AlvinStf/electronic-drum-kit/firmware/library_patch/README.txt

hellodrum.cpp adalah SALINAN PERSIS lampiran pengguna, bukan patch algoritma baru.

Gunakan untuk mengganti src/hellodrum.cpp dalam instalasi HelloDrum yang aktif
hanya bila instalasi tersebut belum memakai versi ini. Cadangkan berkas lama.
Pertahankan hellodrum.h dan berkas pendukung lain yang cocok dari instalasi Anda.

JANGAN masukkan .cpp ini ke folder sketch dan JANGAN #include .cpp langsung:
itu berpotensi membuat definisi ganda dengan library HelloDrum yang terpasang.

Filter FSRSensing alpha=0.01, delay(1), skala/polaritas ADC, status pedal, dan
seluruh logika lain tidak diubah. SHA-256:
b712c8808129ecfc52d5b6a69663e7c554ee2b78dedabaf64d7eca7d29205d3a
