AlvinStf/electronic-drum-kit/PCB/drumModule/BOM.xlsx

No. | Quantity | Comment | Designator | Footprint | Value | Manufacturer Part | Manufacturer | Supplier Part | Supplier
1 | 1 | 10uF | C1 | C0805 | 10uF | CL21A106KAYNNNE | SAMSUNG(三星) | C15850 | LCSC
2 | 1 | 100nF | C2 | C0805 | 100nF | CL21B104KCFNNNE | SAMSUNG(三星) | C28233 | LCSC
3 | 1 | 4.7uF | C3 | C0805 | 4.7uF | CL21A475KAQNNNE | SAMSUNG(三星) | C1779 | LCSC
4 | 2 | 1uF | C4,C6 | C0805 | 1uF | CL21B105KBFNNNE | SAMSUNG(三星) | C28323 | LCSC
5 | 2 | 100uF | C5,C7 | C1206 | 100uF | CL31A107MQHNNNE | SAMSUNG(三星) | C15008 | LCSC
6 | 9 | 10nF | C8,C9,C10,C11,C12,C13,C14,C15,C16 | C0805 | 10nF | CL21B103KBANNNC | SAMSUNG(三星) | C1710 | LCSC
7 | 1 | PJ-603 | CN1 | AUDIO-TH_PJ-603 |  | PJ-603 | Legion(六钧) | C41409498 | LCSC
8 | 1 | HDR-F_2.54_1x8P | H1 | HDR-TH_8P-P2.54-V-F-1
9 | 9 | PJ-612 | J1,J2,J3,J4,J5,J6,J8,J9,J10 | AUDIO-TH_PJ-612 |  | PJ-612 | HOOYA(皓宇电子) | C309284 | LCSC
10 | 14 | 100kΩ | R1,R2,R3,R4,R5,R7,R9,R12,R13,R17,R19,R23,R25,R27 | R0805 | 100kΩ | 0805W8F1003T5E | UNI-ROYAL(厚声) | C149504 | LCSC
11 | 10 | 1MΩ | R6,R8,R10,R14,R15,R20,R21,R24,R26,R28 | R0805 | 1MΩ | 0805W8F1004T5E | UNI-ROYAL(厚声) | C17514 | LCSC
12 | 3 | 10kΩ | R11,R22,R32 | R0805 | 10kΩ | 0805W8F1002T5E | UNI-ROYAL(厚声) | C17414 | LCSC
13 | 2 | 4.7kΩ | R16,R33 | R0805 | 4.7kΩ | KTR10EZPF4701 | ROHM(罗姆) | C2087066 | LCSC
14 | 1 | 10kΩ | R30 | RES-ADJ-TH_RK09L1140A65 | 10kΩ | RK09L1140A66 | ALPSALPINE(阿尔卑斯阿尔派) | C470447 | LCSC
15 | 3 | Key_SMD_6x6x10.5 | SW1,SW2,SW3 | KEY-SMD_4P-L6.0-W6.0-P3.90-LS9.0
16 | 1 | TDA1308T/N1 | U1 | SOIC-8_L4.9-W3.9-P1.27-LS6.0-BL |  | TDA1308T/N1 | NXP(恩智浦) | C29767341 | LCSC
17 | 1 | PCM5102 | U2 | PCM5102 | PCM5102
18 | 1 | ESP32-S3-N16R8 | U4 | COMM-TH_ESP32-S3-DEVKITC-N16R8 |  | ESP32-S3-N16R8 |  | C9900309792 | LCSC
19 | 1 | PJ-307 | U5 | AUDIO-TH_PJ-307N5 |  | PJ-307 |  | C9900013026 | LCSC
20 | 10 | BZT52C3V3 | ZD1,ZD2,ZD3,ZD4,ZD5,ZD6,ZD7,ZD8,ZD9,ZD10 | SOD-123_L2.8-W1.8-LS3.7-RD |  | BZT52C3V3 | CJ(江苏长电/长晶) | C2112 | LCSC
