AlvinStf/electronic-drum-kit/PCB/sensors/BOM.xlsx

No. | Quantity | Comment | Designator | Footprint | Value | Manufacturer Part | Manufacturer | Supplier Part | Supplier
1 | 1 | 100pF | C1 | C0805 | 100pF | CL21C101JBANNNC | SAMSUNG(三星) | C1790 | LCSC
2 | 1 | S3B-XH-A(LF)(SN) | CN1 | CONN-TH_S3B-XH-A-LF-SN |  | S3B-XH-A(LF)(SN) | JST | C157928 | LCSC
3 | 1 | 1N4148W | D1 | SOD-123F_L2.7-W1.6-LS3.8-RD |  | 1N4148W | ST(先科) | C81598 | LCSC
4 | 1 | HDR-F_2.54_1x3P | H1 | HDR-TH_3P-P2.54-V-F
5 | 3 | 2.54-1*2P母 | H2,H3,H4 | HDR-TH_2P-P2.54-V-F |  | 2.54-1*2P母 | BOOMELE(博穆精密) | C49661 | LCSC
6 | 2 | 10kΩ | R1,R7 | R0805 | 10kΩ | 0805W8F1002T5E | UNI-ROYAL(厚声) | C17414 | LCSC
7 | 2 | 150kΩ | R2,R5 | R0805 | 150kΩ | 0805W8F1503T5E | UNI-ROYAL(厚声) | C17470 | LCSC
8 | 1 | 220Ω | R3 | R0805 | 220Ω | 0805W8F2200T5E | UNI-ROYAL(厚声) | C17557 | LCSC
9 | 1 | 1kΩ | R4 | R0805 | 1kΩ | 0805W8F1001T5E | UNI-ROYAL(厚声) | C17513 | LCSC
10 | 1 | 47kΩ | R6 | R0805 | 47kΩ | 0805W8F4702T5E | UNI-ROYAL(厚声) | C17713 | LCSC
11 | 6 | TS-1101-C-W | SW1,SW2,SW3,SW4,SW5,SW6 | SW-SMD_L6.0-W3.3-LS8.0_TS-1101-C-W |  | TS-1101-C-W | XKB Connection(中国星坤) | C318938 | LCSC
12 | 4 | TS5208A 160gf 025 | U1,U2,U3,U4 | KEY-SMD_4P-L4.8-W4.8-P3.70-LS6.4-TL |  | TS5208A 160gf 025 | SHOU HAN(首韩) | C5363479 | LCSC
