AlvinStf/electronic-drum-kit/hardware/STLs/Hi-hat Main Body.STL

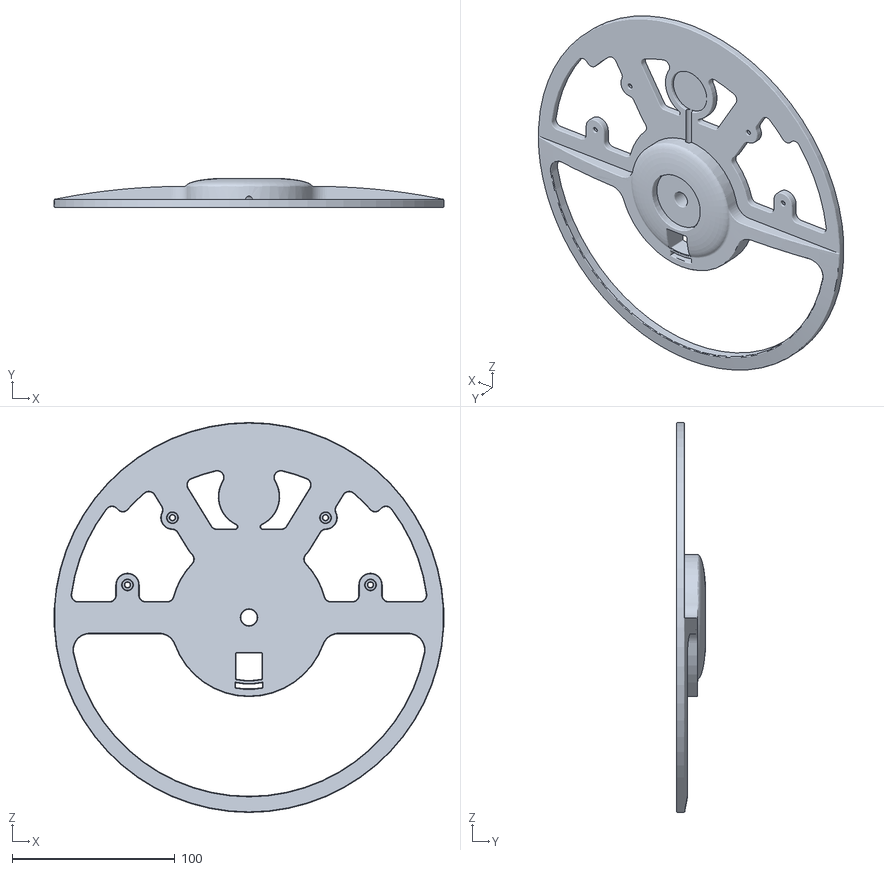
[picture p1: CAD file, 2026-10-14]
hardware/STLs/Hi-hat Main Body.STL
240.0 x 17.9 x 240.0
