AlvinStf/electronic-drum-kit/hardware/STLs/Cymbal Main Body.STL

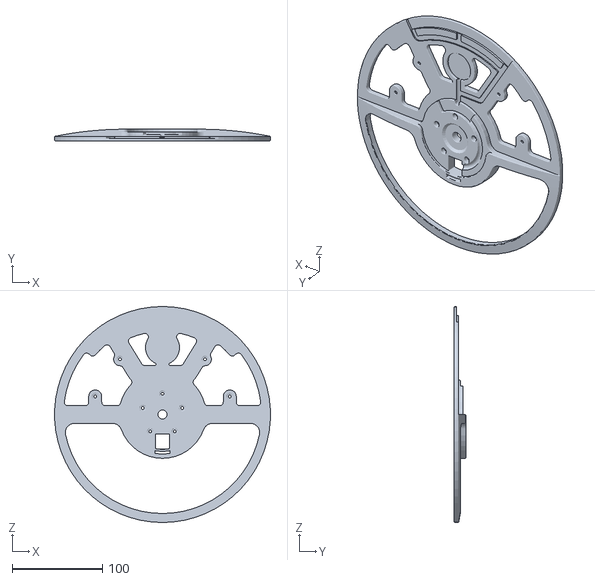
[picture p2: CAD file, 2026-10-14]
hardware/STLs/Cymbal Main Body.STL
240.0 x 13.0 x 240.0
