AlvinStf/electronic-drum-kit/hardware/STLs/Tee Joint - Toolless (B).STL

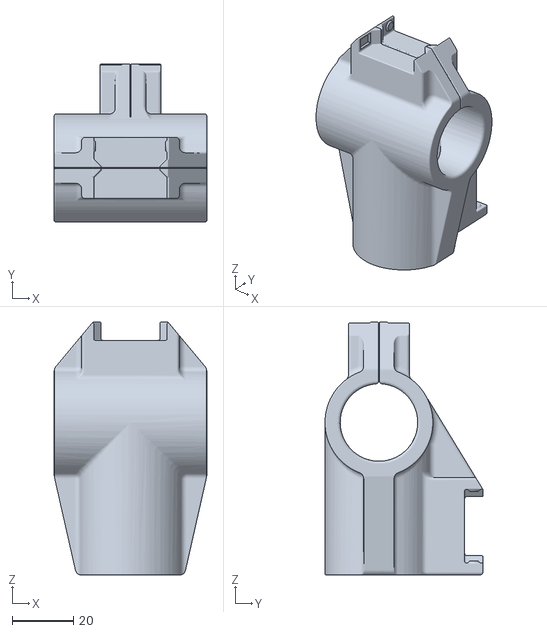
[picture p3: CAD file, 2026-10-14]
hardware/STLs/Tee Joint - Toolless (B).STL
50.0 x 51.8 x 82.9
