AlvinStf/electronic-drum-kit/hardware/STLs/HHC Foot Rest.STL

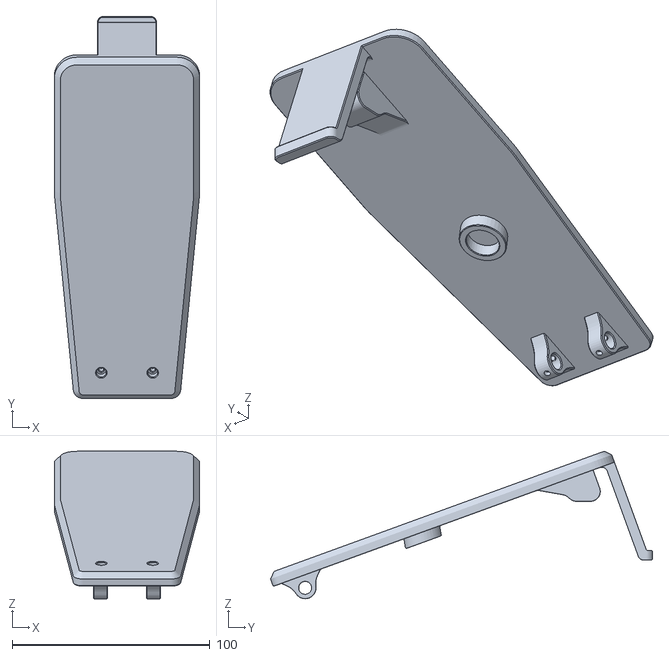
[picture p4: CAD file, 2026-10-14]
hardware/STLs/HHC Foot Rest.STL
73.5 x 193.2 x 74.6
