AlvinStf/electronic-drum-kit/hardware/STLs/Rubber Feet Pad.STL

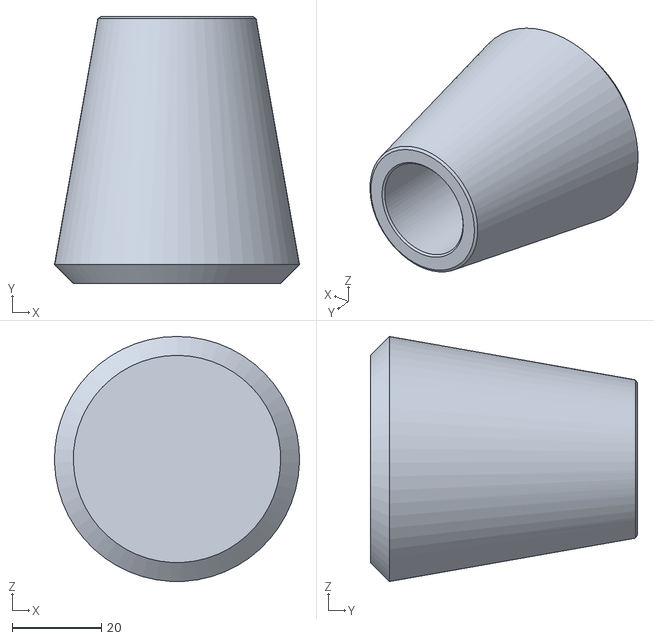
[picture p5: CAD file, 2026-10-14]
hardware/STLs/Rubber Feet Pad.STL
55.0 x 60.0 x 55.1
