AlvinStf/electronic-drum-kit/hardware/STLs/Snare Shell.STL

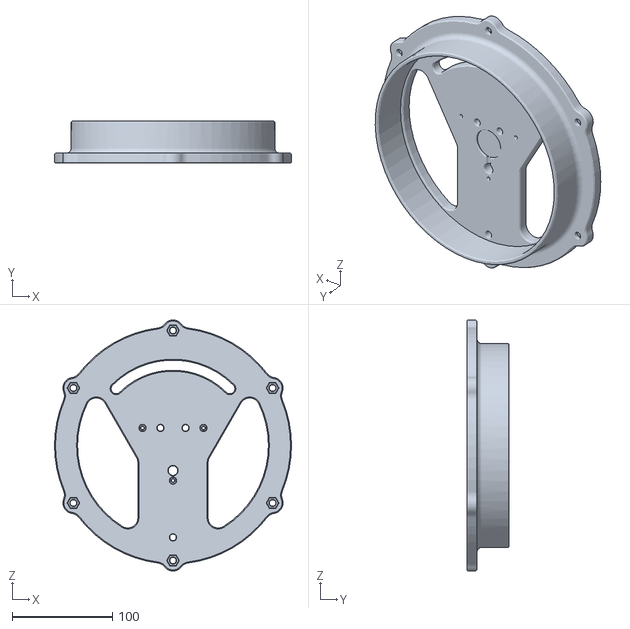
[picture p6: CAD file, 2026-10-14]
hardware/STLs/Snare Shell.STL
236.0 x 42.0 x 249.9
