AlvinStf/electronic-drum-kit/hardware/STLs/Tee Joint & Cymbal Mount.STL

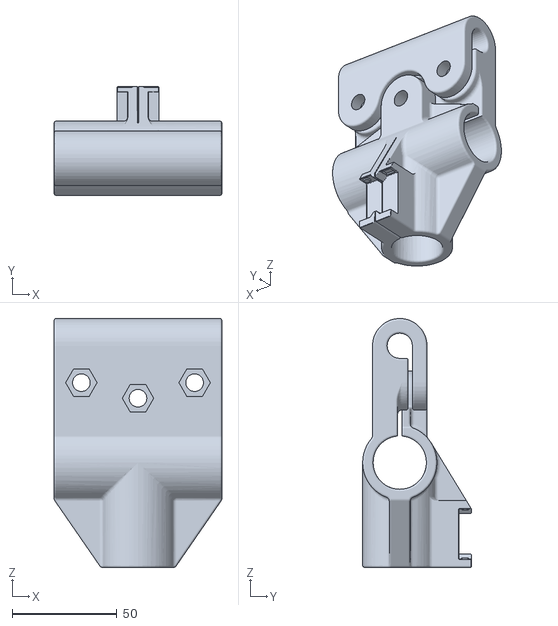
[picture p7: CAD file, 2026-10-14]
hardware/STLs/Tee Joint & Cymbal Mount.STL
80.0 x 51.8 x 118.7
