AlvinStf/electronic-drum-kit/hardware/STLs/Tom Mount.STL

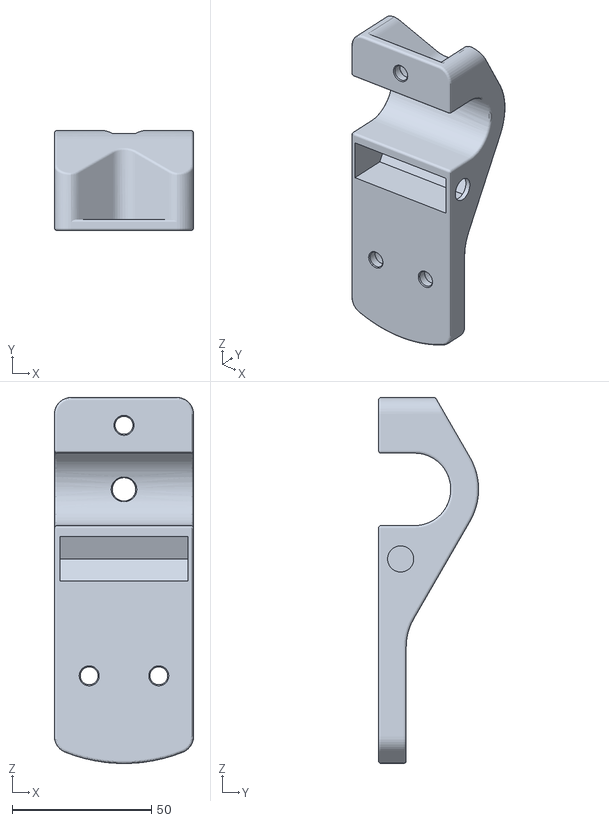
[picture p8: CAD file, 2026-10-14]
hardware/STLs/Tom Mount.STL
50.0 x 36.0 x 131.5
