AlvinStf/electronic-drum-kit/hardware/STLs/Cymbal Edge.STL

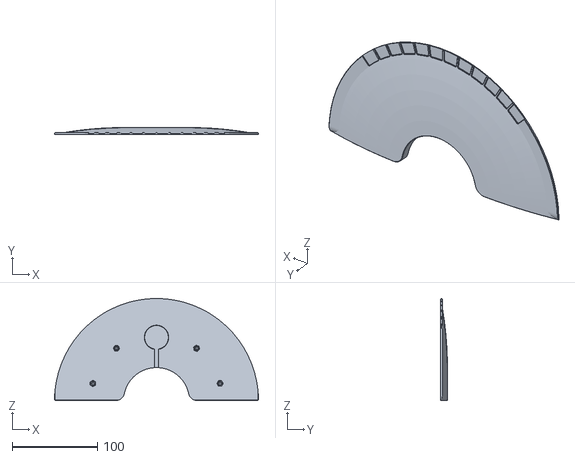
[picture p9: CAD file, 2026-10-14]
hardware/STLs/Cymbal Edge.STL
240.0 x 8.00 x 120.0
