AlvinStf/electronic-drum-kit/hardware/STLs/KTP Pin 1.STL

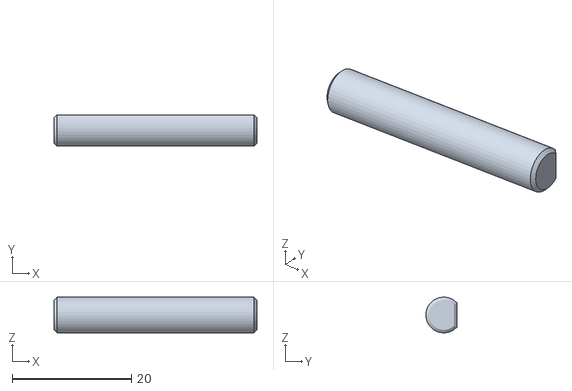
[picture p10: CAD file, 2026-10-14]
hardware/STLs/KTP Pin 1.STL
34.0 x 5.24 x 6.00
