AlvinStf/electronic-drum-kit/hardware/STLs/Cymbal Socket.STL

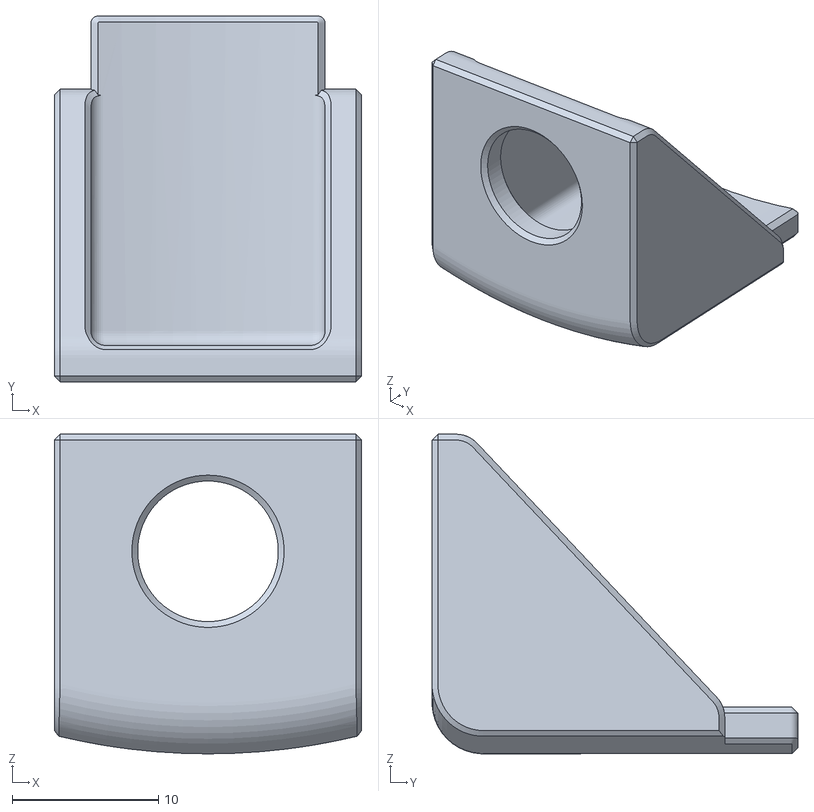
[picture p11: CAD file, 2026-10-14]
hardware/STLs/Cymbal Socket.STL
21.0 x 25.0 x 21.8
