AlvinStf/electronic-drum-kit/hardware/STLs/Sensor Plate.STL

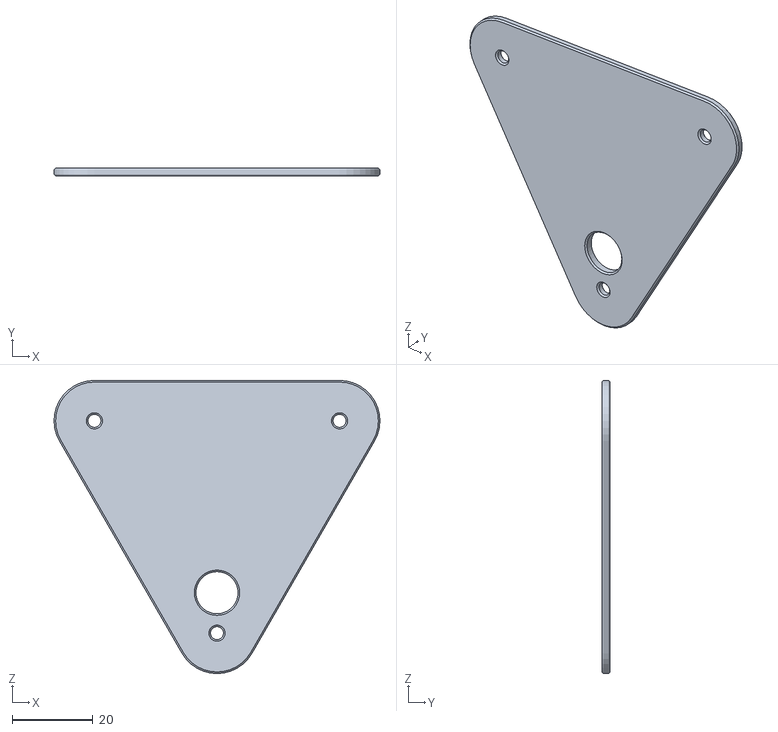
[picture p12: CAD file, 2026-10-14]
hardware/STLs/Sensor Plate.STL
80.6 x 2.00 x 72.5
