AlvinStf/electronic-drum-kit/hardware/STLs/Single Zone Pad.STL

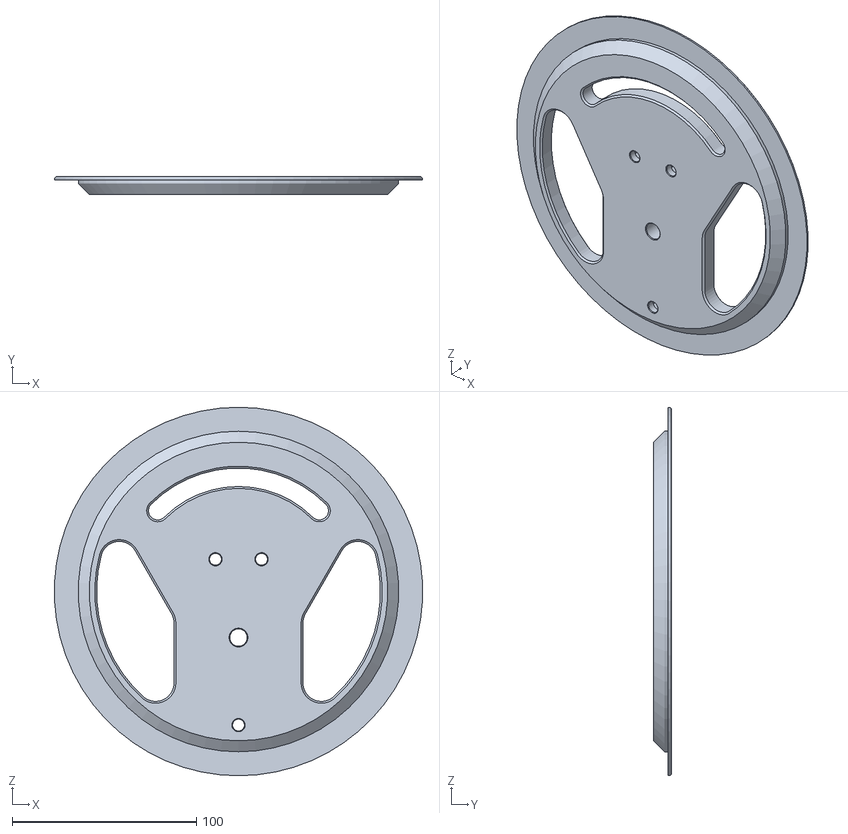
[picture p13: CAD file, 2026-10-14]
hardware/STLs/Single Zone Pad.STL
199.7 x 10.0 x 200.0
