AlvinStf/electronic-drum-kit/hardware/STLs/HHC Base.STL

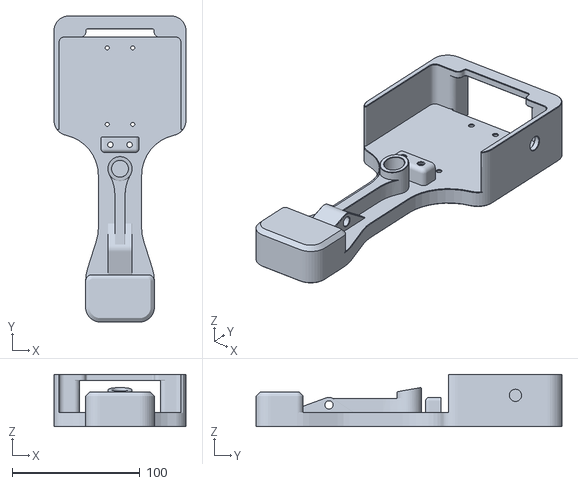
[picture p14: CAD file, 2026-10-14]
hardware/STLs/HHC Base.STL
103.5 x 240.0 x 41.0
