AlvinStf/electronic-drum-kit/hardware/STLs/HHC Pin.STL

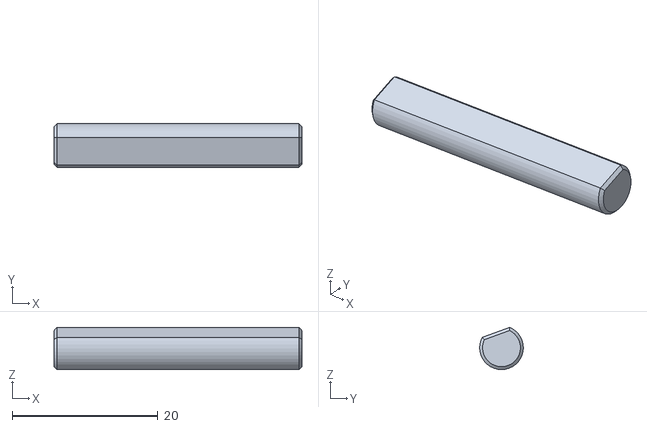
[picture p15: CAD file, 2026-10-14]
hardware/STLs/HHC Pin.STL
34.0 x 6.00 x 5.79
