AlvinStf/electronic-drum-kit/hardware/STLs/Dop.STL

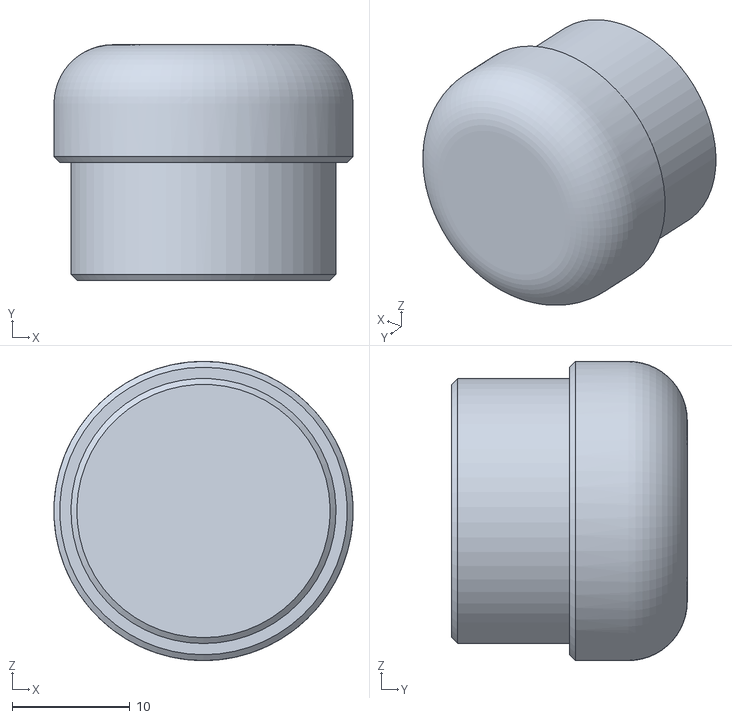
[picture p16: CAD file, 2026-10-14]
hardware/STLs/Dop.STL
25.4 x 20.0 x 25.4
