AlvinStf/electronic-drum-kit/hardware/STLs/Cymbal Mount.STL

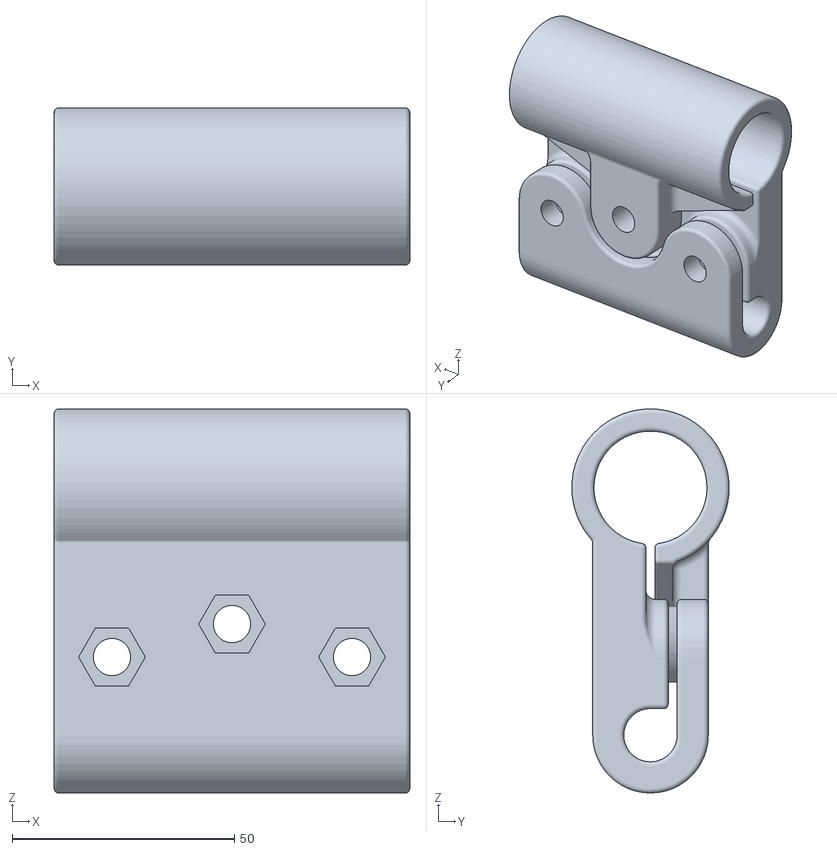
[picture p17: CAD file, 2026-10-14]
hardware/STLs/Cymbal Mount.STL
80.0 x 35.4 x 86.4
