AlvinStf/electronic-drum-kit/hardware/STLs/Rim.STL

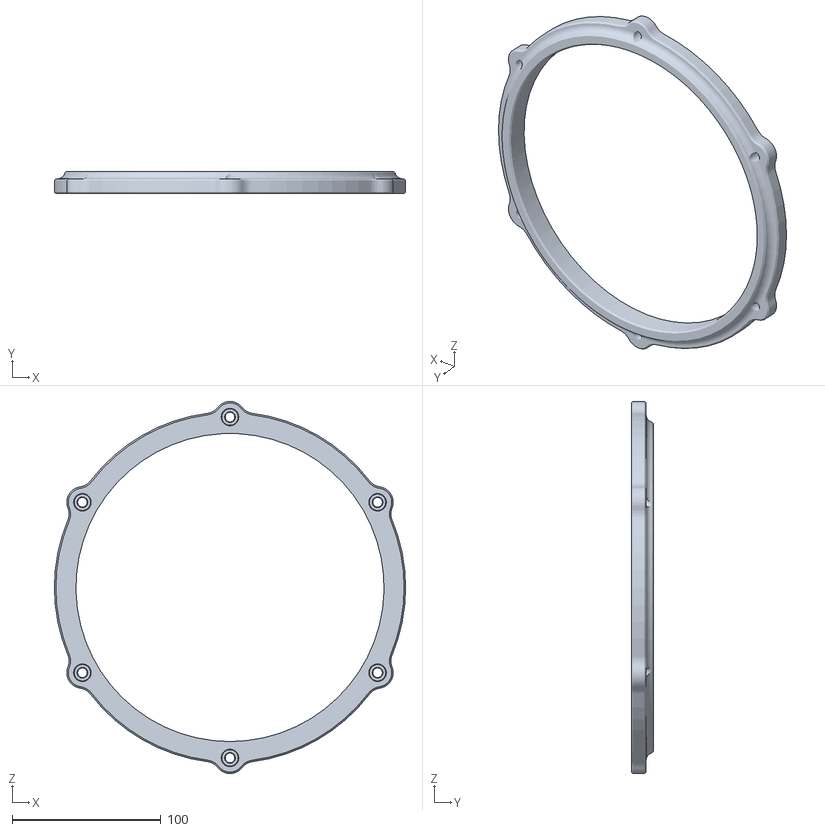
[picture p18: CAD file, 2026-10-14]
hardware/STLs/Rim.STL
236.0 x 15.0 x 249.9
