AlvinStf/electronic-drum-kit/hardware/STLs/Snare Mount.STL

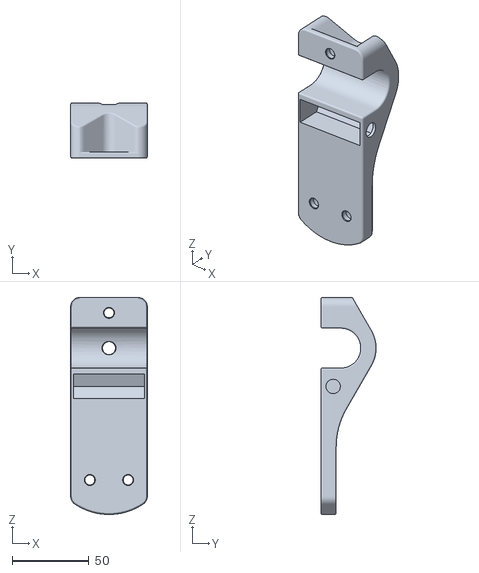
[picture p19: CAD file, 2026-10-14]
hardware/STLs/Snare Mount.STL
50.0 x 36.0 x 141.5
