AlvinStf/electronic-drum-kit/hardware/STLs/KTP Pin 2.STL

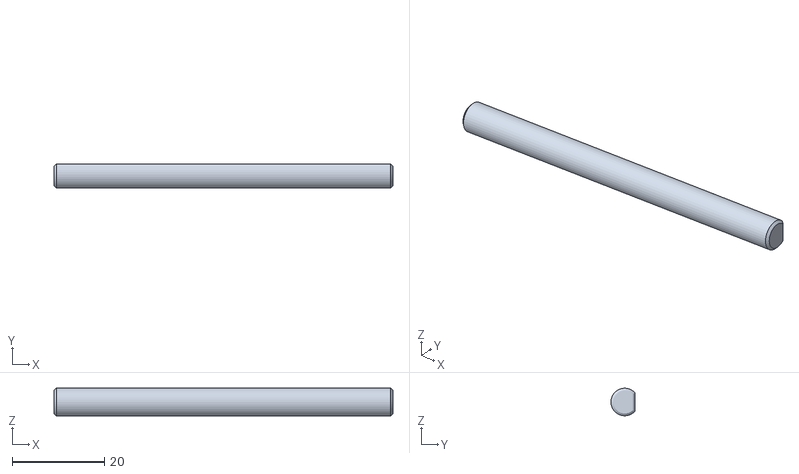
[picture p20: CAD file, 2026-10-14]
hardware/STLs/KTP Pin 2.STL
73.5 x 5.24 x 6.00
