AlvinStf/electronic-drum-kit/hardware/STLs/Cymbal Bell.STL

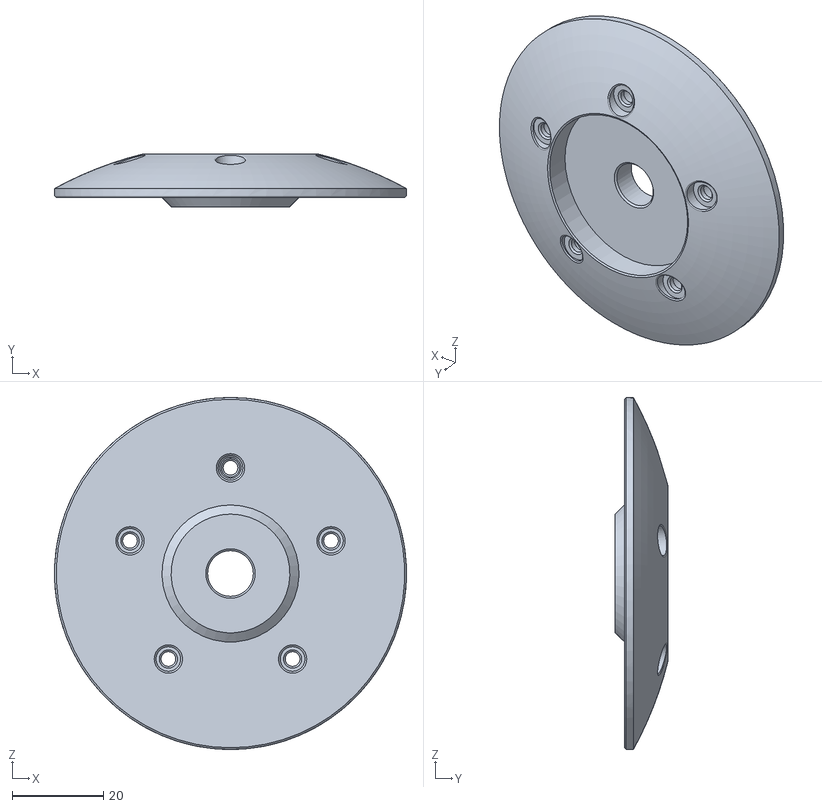
[picture p21: CAD file, 2026-10-14]
hardware/STLs/Cymbal Bell.STL
77.0 x 11.5 x 77.1
