AlvinStf/electronic-drum-kit/hardware/STLs/Drum Module Mount.STL

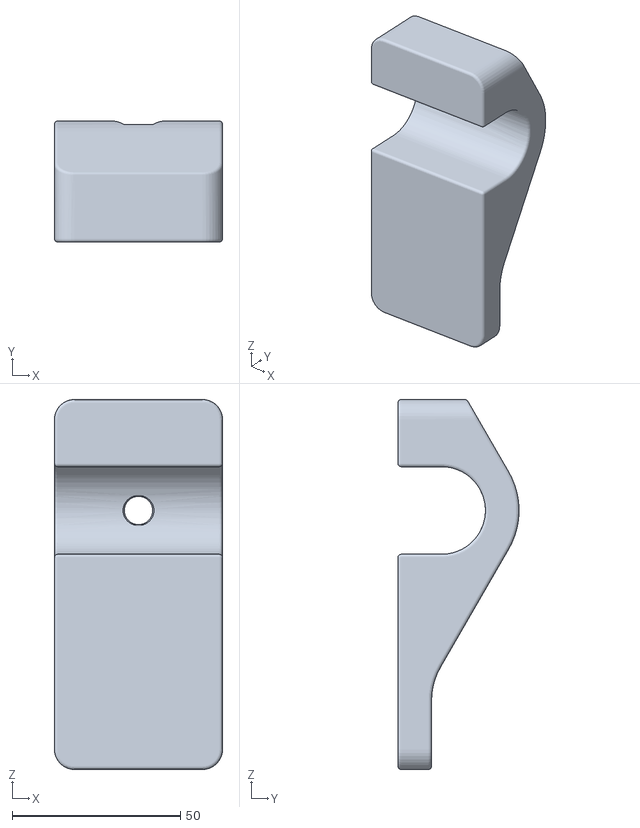
[picture p22: CAD file, 2026-10-14]
hardware/STLs/Drum Module Mount.STL
50.0 x 36.0 x 110.0
