AlvinStf/electronic-drum-kit/hardware/STLs/KTP Pin 3.STL

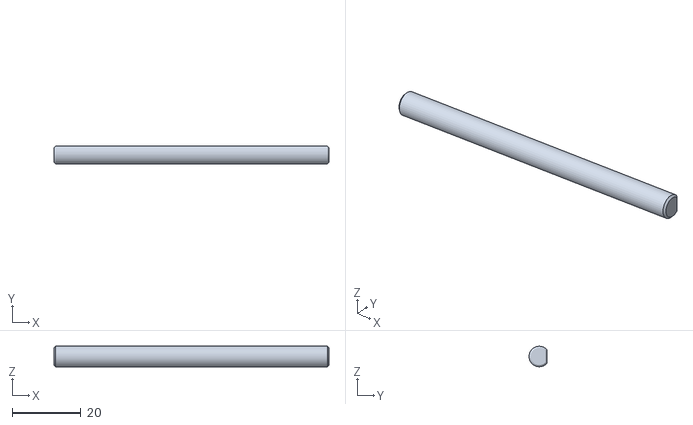
[picture p23: CAD file, 2026-10-14]
hardware/STLs/KTP Pin 3.STL
80.0 x 5.24 x 6.00
