AlvinStf/electronic-drum-kit/hardware/STLs/Cymbal Stand Sleeve.STL

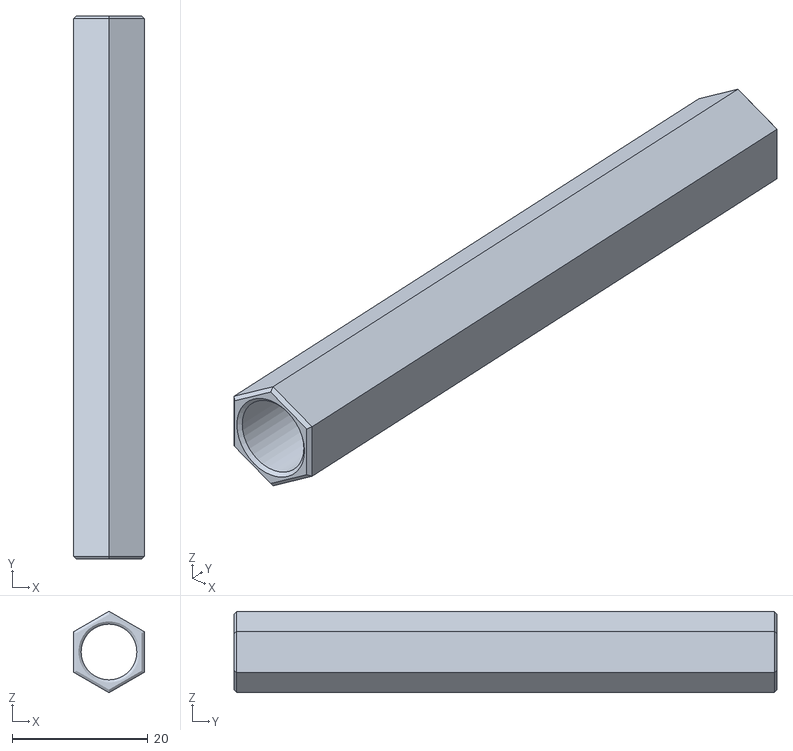
[picture p24: CAD file, 2026-10-14]
hardware/STLs/Cymbal Stand Sleeve.STL
10.4 x 80.0 x 12.0
