AlvinStf/electronic-drum-kit/hardware/STLs/KTP Foot Rest.STL

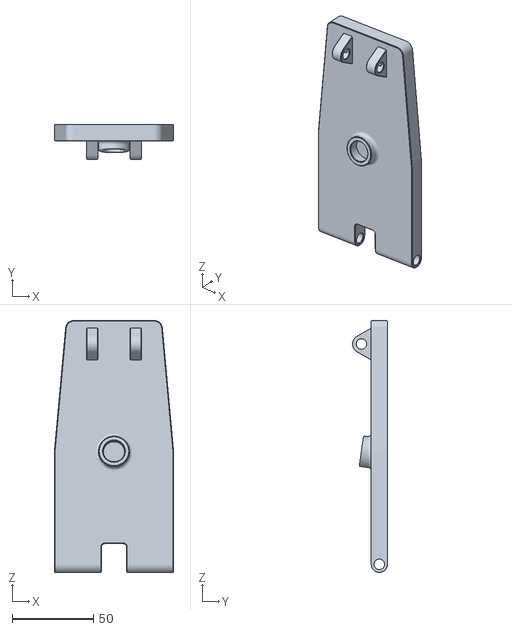
[picture p25: CAD file, 2026-10-14]
hardware/STLs/KTP Foot Rest.STL
73.5 x 21.5 x 155.0
