AlvinStf/electronic-drum-kit/hardware/STLs/HHC Trigger.STL

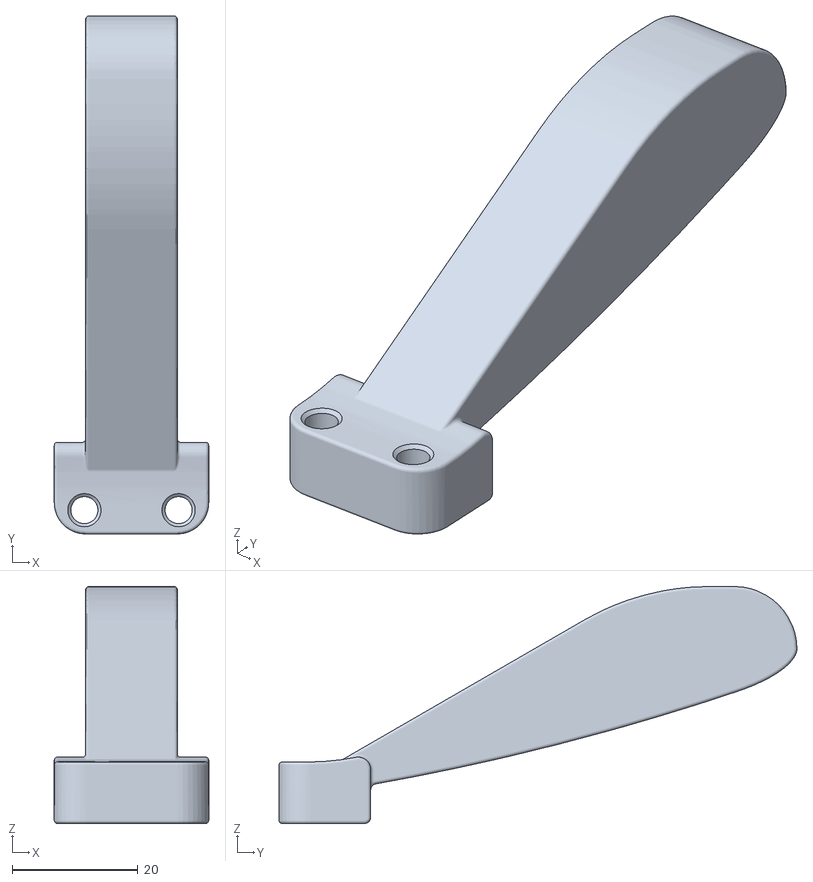
[picture p26: CAD file, 2026-10-14]
hardware/STLs/HHC Trigger.STL
24.6 x 82.5 x 37.7
