AlvinStf/electronic-drum-kit/hardware/STLs/Cymbal Sleeve.STL

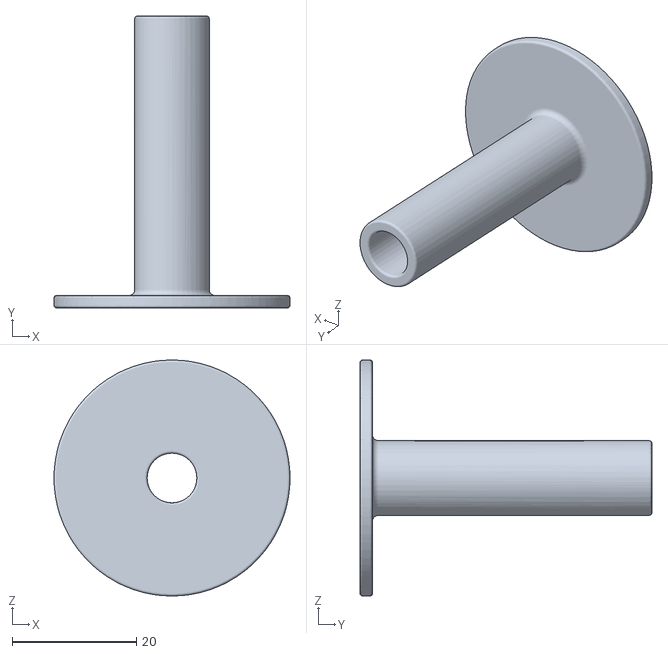
[picture p27: CAD file, 2026-10-14]
hardware/STLs/Cymbal Sleeve.STL
38.0 x 47.0 x 38.0
