AlvinStf/electronic-drum-kit/hardware/STLs/Clasp.STL

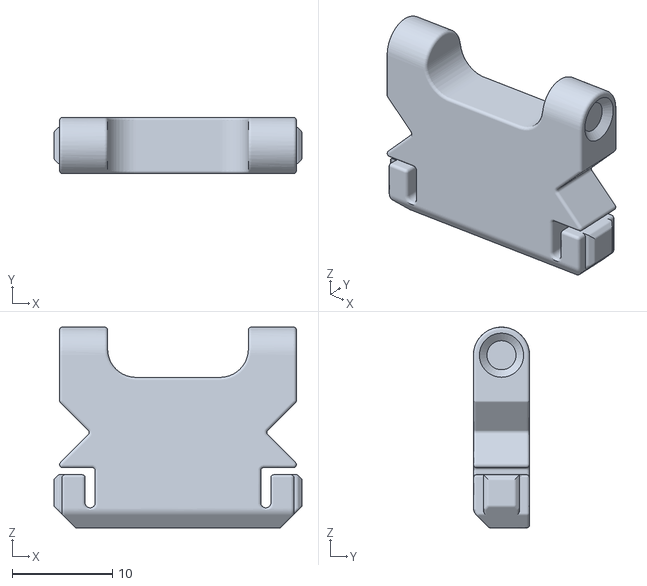
[picture p28: CAD file, 2026-10-14]
hardware/STLs/Clasp.STL
24.7 x 5.60 x 20.0
