AlvinStf/electronic-drum-kit/hardware/STLs/KTP Linkage 1.STL

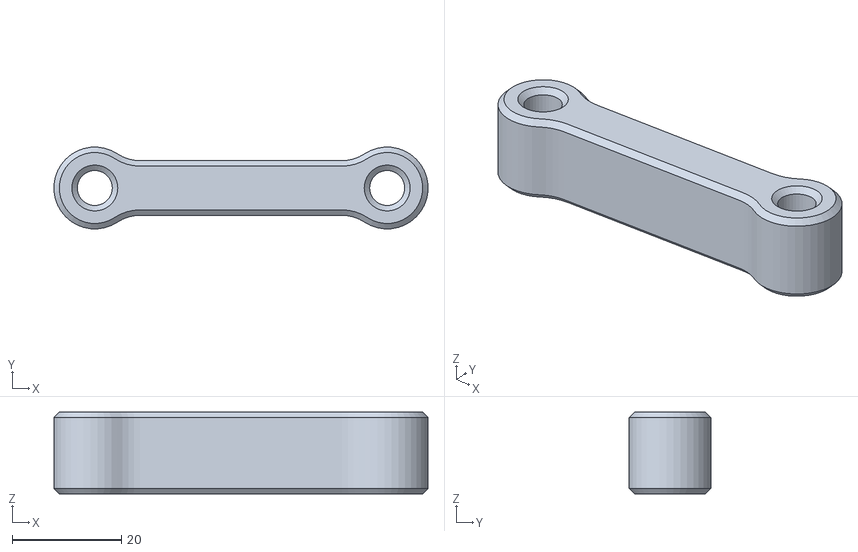
[picture p29: CAD file, 2026-10-14]
hardware/STLs/KTP Linkage 1.STL
68.4 x 15.0 x 15.0
