AlvinStf/electronic-drum-kit/hardware/STLs/KTP Hammer.STL

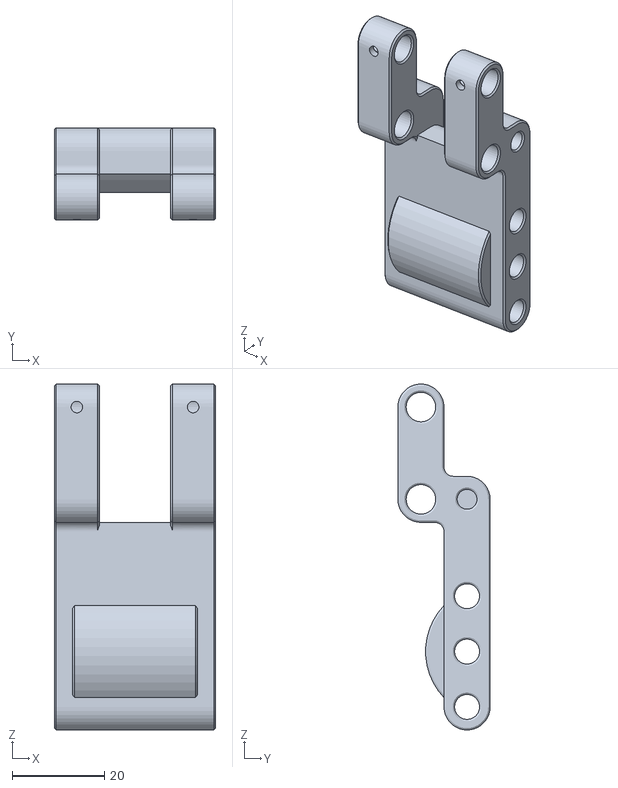
[picture p30: CAD file, 2026-10-14]
hardware/STLs/KTP Hammer.STL
35.0 x 20.0 x 75.0
