AlvinStf/electronic-drum-kit/hardware/STLs/Bottom Pad.STL

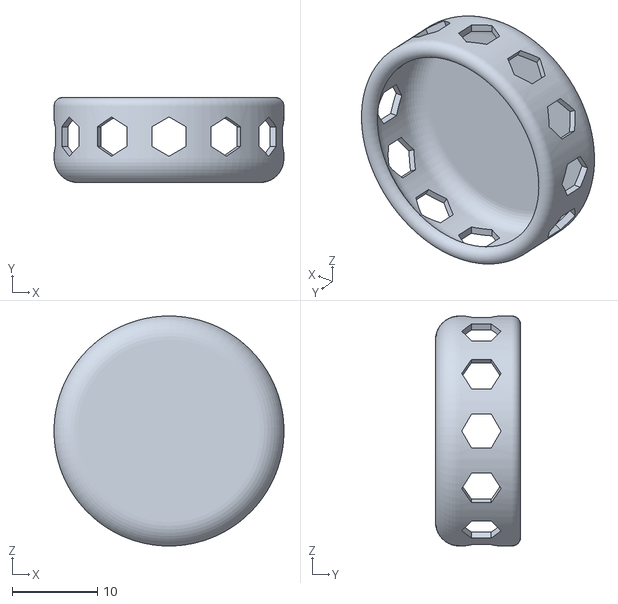
[picture p31: CAD file, 2026-10-14]
hardware/STLs/Bottom Pad.STL
27.0 x 10.0 x 27.0
