AlvinStf/electronic-drum-kit/hardware/STLs/Pin.STL

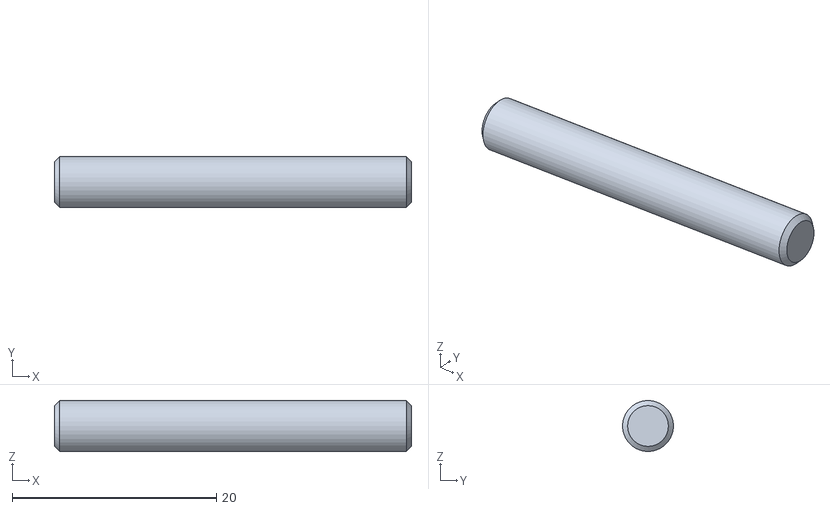
[picture p32: CAD file, 2026-10-14]
hardware/STLs/Pin.STL
35.0 x 5.00 x 5.00
