AlvinStf/electronic-drum-kit/hardware/STLs/Knob Adapter.STL

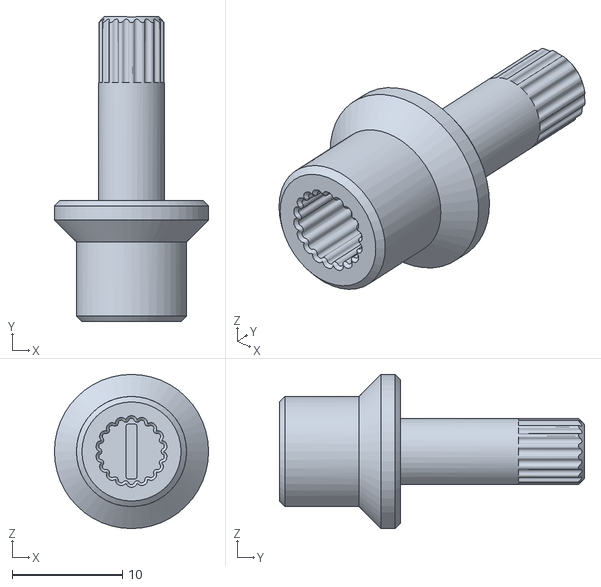
[picture p33: CAD file, 2026-10-14]
hardware/STLs/Knob Adapter.STL
14.0 x 27.7 x 14.0
