AlvinStf/electronic-drum-kit/hardware/STLs/HHC Spacer.STL

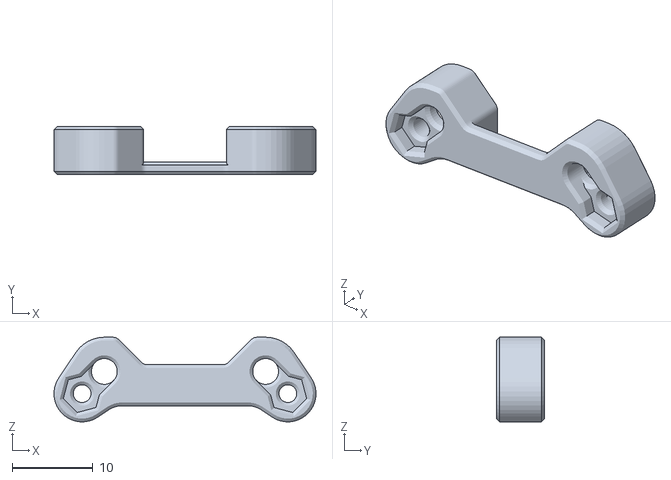
[picture p34: CAD file, 2026-10-14]
hardware/STLs/HHC Spacer.STL
32.5 x 6.00 x 10.5
