AlvinStf/electronic-drum-kit/hardware/STLs/Trigger Cone.STL

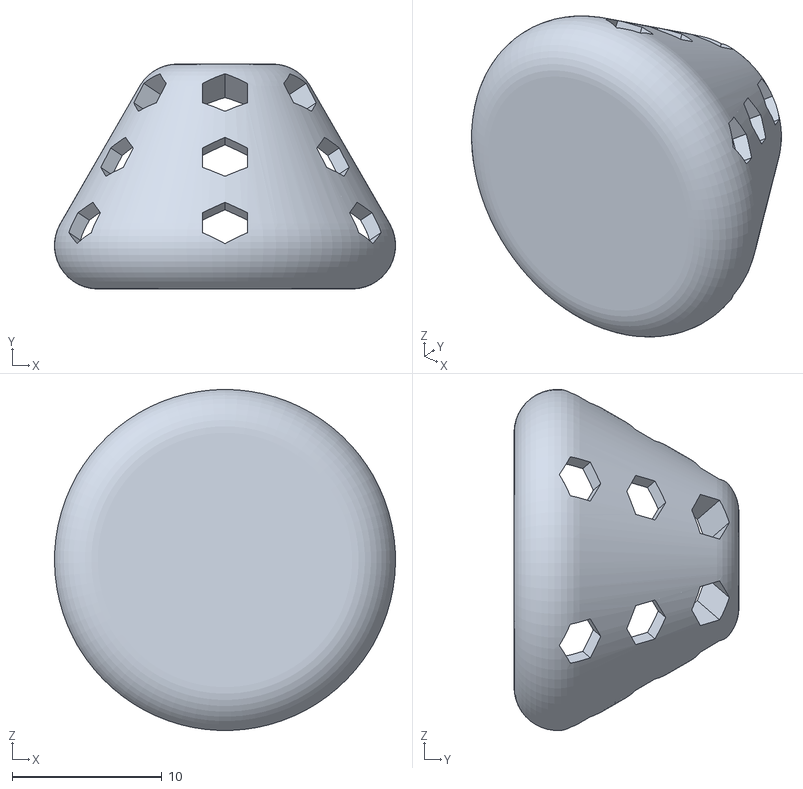
[picture p35: CAD file, 2026-10-14]
hardware/STLs/Trigger Cone.STL
22.7 x 15.0 x 22.7
