AlvinStf/electronic-drum-kit/hardware/STLs/KTP Base.STL

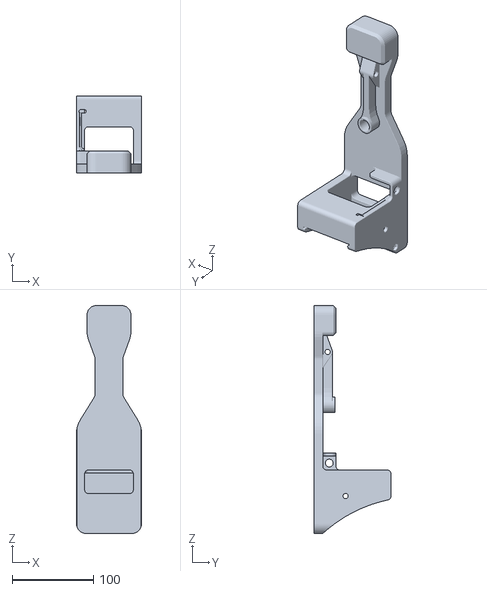
[picture p36: CAD file, 2026-10-14]
hardware/STLs/KTP Base.STL
80.0 x 95.0 x 280.0
