AlvinStf/electronic-drum-kit/hardware/STLs/KTP Pad.STL

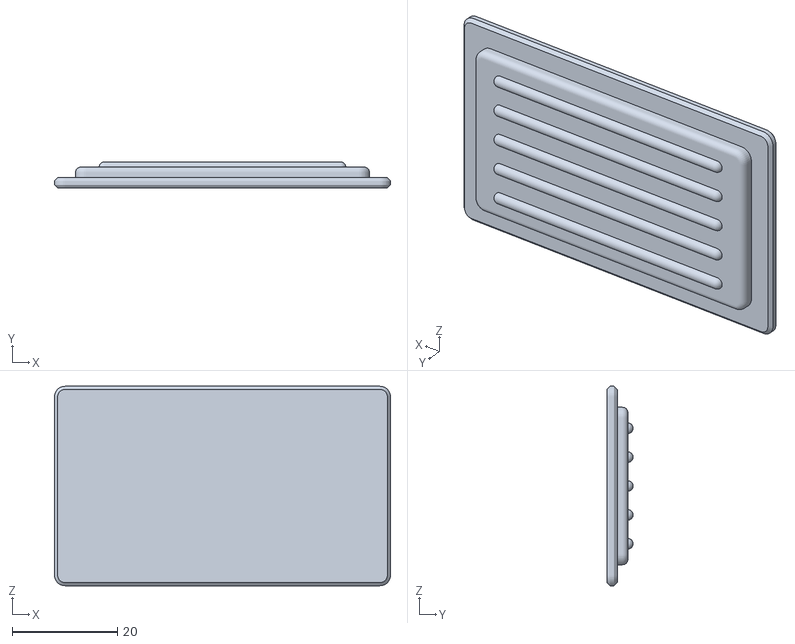
[picture p37: CAD file, 2026-10-14]
hardware/STLs/KTP Pad.STL
64.0 x 5.00 x 38.0
