AlvinStf/electronic-drum-kit/(list of files, cad)

Other CAD files:
hardware/STLs/Hi-hat Edge.STL
hardware/STLs/Tee Joint - Toolless (A).STL
hardware/STLs/Thumb Screw.STL
