AlvinStf/electronic-drum-kit/PCB/drumModule/gerber/How-to-order-PCB.txt

How to Order PCB

Please refer to:
https://prodocs.easyeda.com/en/pcb/order-order-pcb/index.html
