AlvinStf/electronic-drum-kit/PCB/drumModule/schematic/SCH_drumModule.pdf

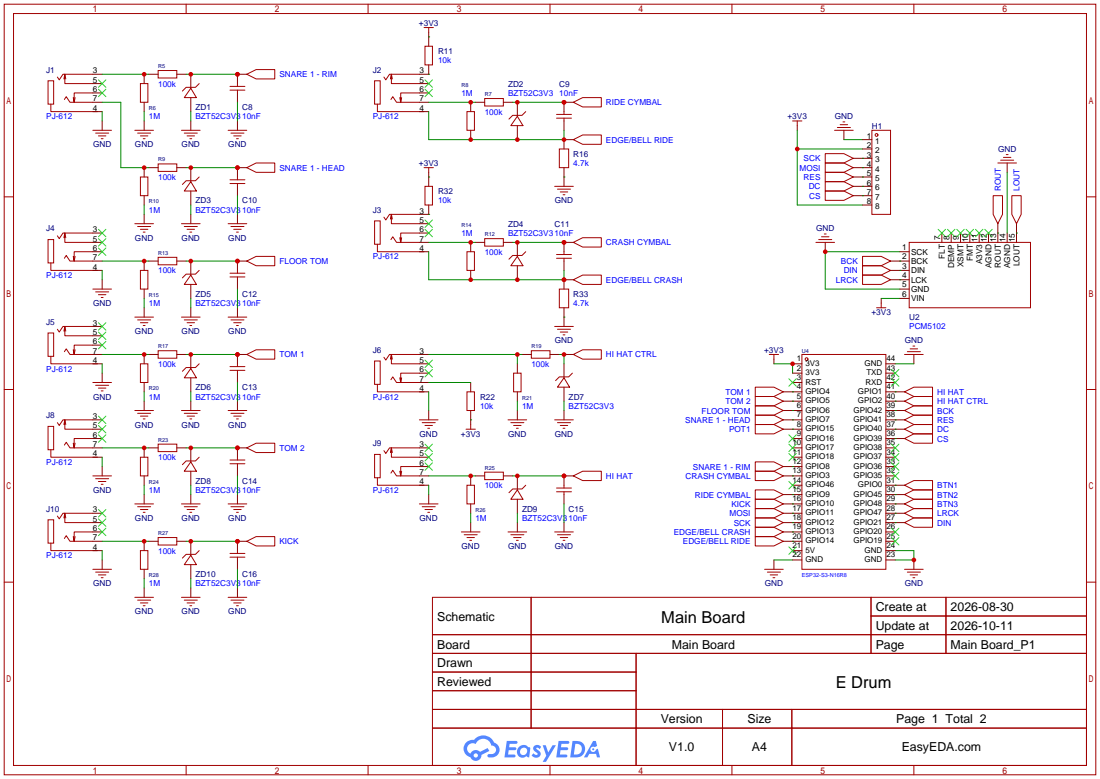
[picture p38: page 1]

Schematic | Main Board | Create at | 2026-08-30

Update at | 2026-10-11

Board | Main Board | Page | Main Board_P1
Drawn | | E Drum
Reviewed

Version | Size | Page 1 Total 2
V1.0 | A4 | EasyEDA.com

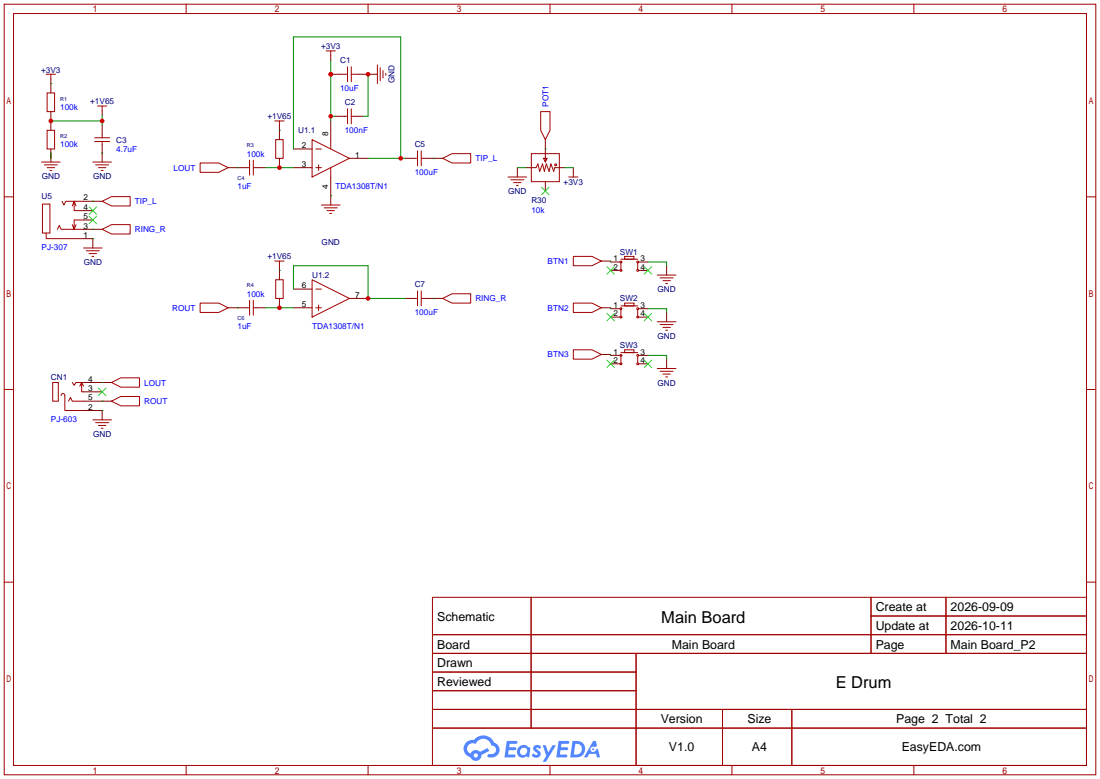
[picture p39: page 2]

Schematic | Main Board | Create at | 2026-09-09

Update at | 2026-10-11

Board | Main Board | Page | Main Board_P2
Drawn | | E Drum
Reviewed

Version | Size | Page 2 Total 2
V1.0 | A4 | EasyEDA.com
