AlvinStf/electronic-drum-kit/PCB/sensors/schematic/SCH_Bell Sensor.pdf

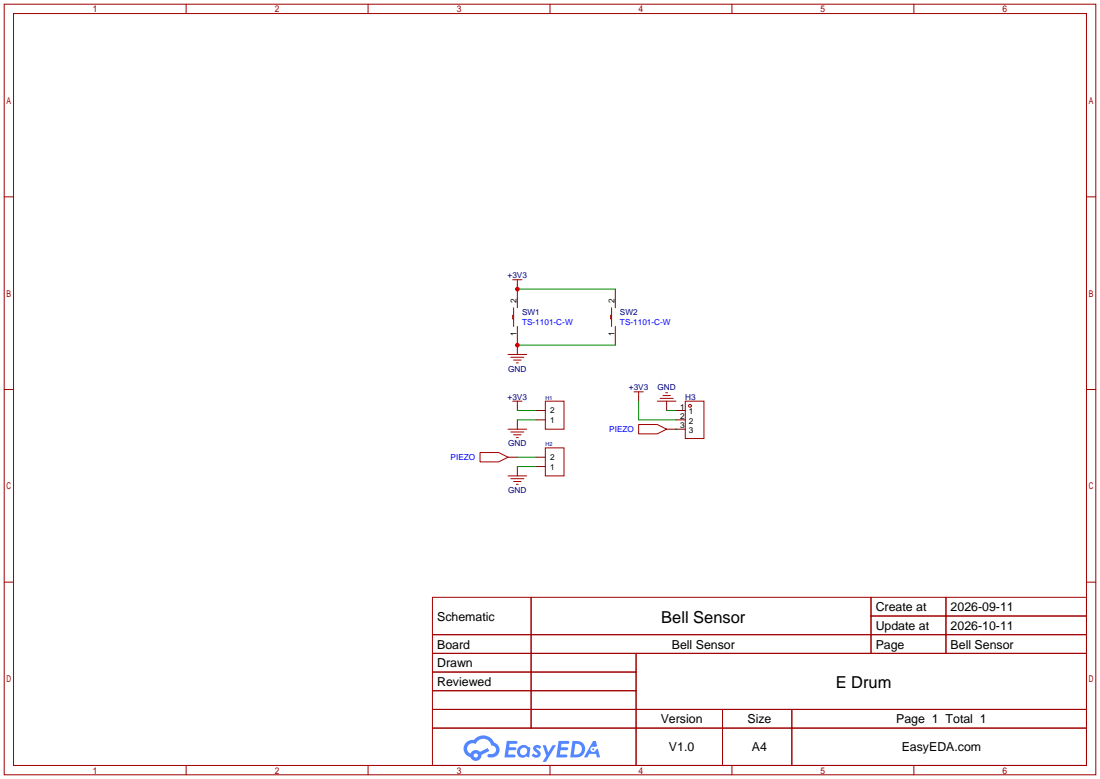
[picture p40: page 1]

Schematic | Bell Sensor | Create at | 2026-09-11

Update at | 2026-10-11

Board | Bell Sensor | Page | Bell Sensor
Drawn | | E Drum
Reviewed

Version | Size | Page 1 Total 1
V1.0 | A4 | EasyEDA.com
