AlvinStf/electronic-drum-kit/PCB/sensors/schematic/SCH_Edge Sensor.pdf

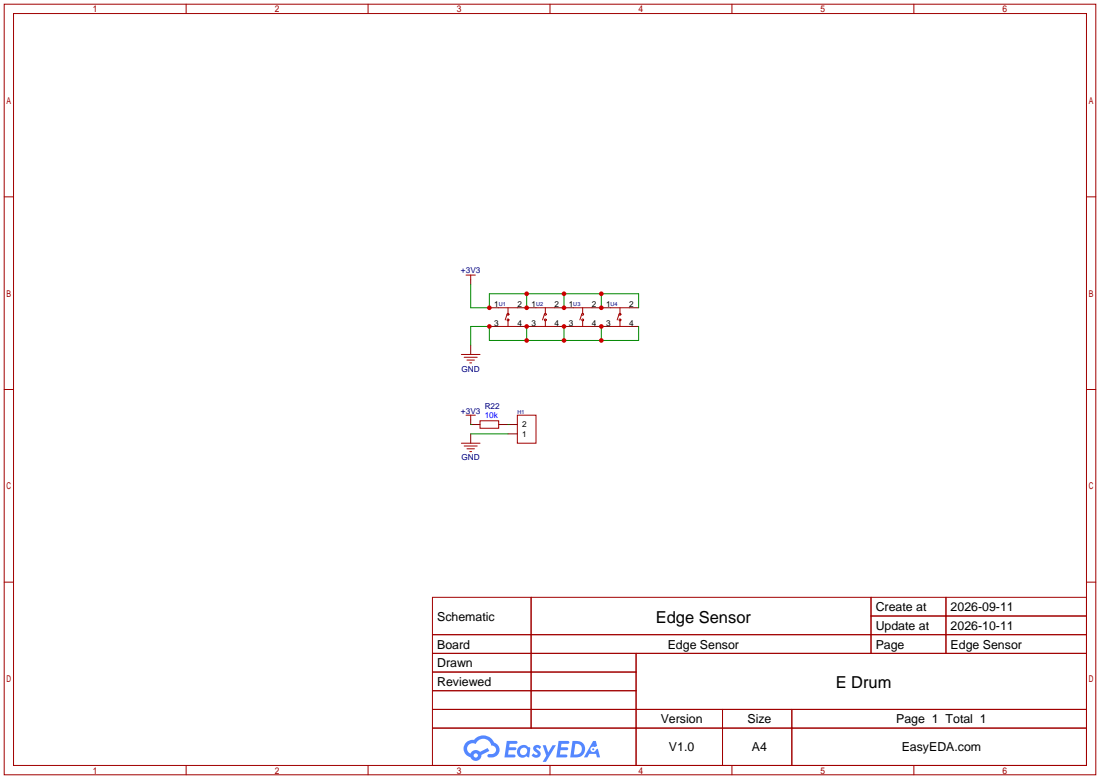
[picture p41: page 1]

Schematic | Edge Sensor | Create at | 2026-09-11

Update at | 2026-10-11

Board | Edge Sensor | Page | Edge Sensor
Drawn | | E Drum
Reviewed

Version | Size | Page 1 Total 1
V1.0 | A4 | EasyEDA.com
