AlvinStf/electronic-drum-kit/PCB/sensors/schematic/SCH_Hi Hat Controller.pdf

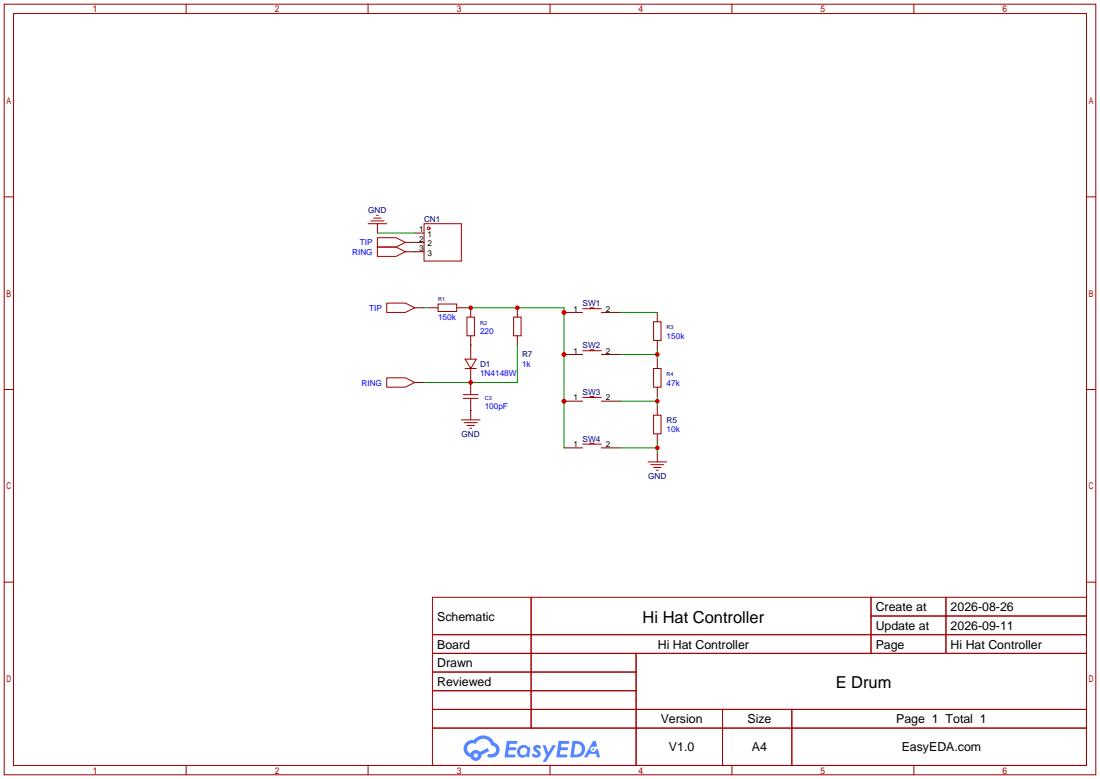
[picture p42: page 1]

Schematic | Hi Hat Controller | Create at | 2026-08-26

Update at | 2026-09-11

Board | Hi Hat Controller | Page | Hi Hat Controller
Drawn | | E Drum
Reviewed

Version | Size | Page 1 Total 1
V1.0 | A4 | EasyEDA.com
