AlvinStf/electronic-drum-kit/PCB/drumModule/PCB_drumModule.pdf

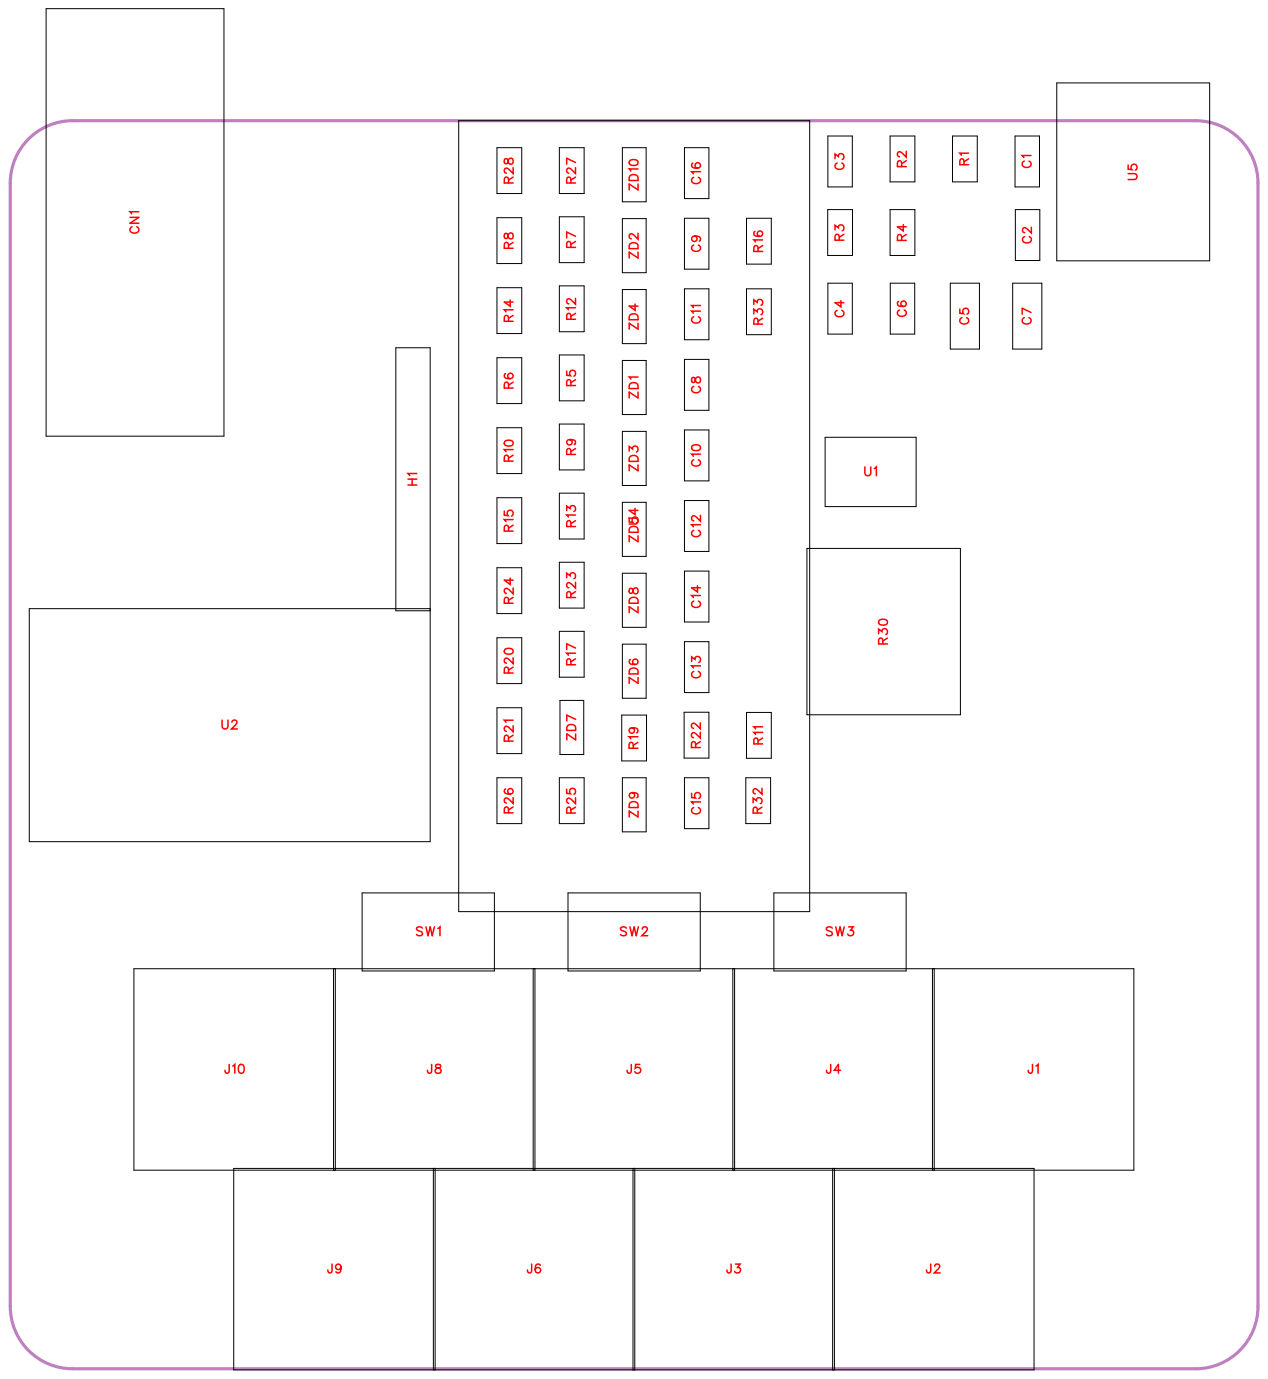
[picture p43: page 1]

No. | Quantity | Comment | Designator | Footprint | Value | Manufacturer Part | Manufacturer | Supplier Part | Supplier
1 | 1 | 10uF | C1 | C0805 | 10uF | CL21A106KA YNNNE | SAMSUNG( 三星) | C15850 | LCSC
2 | 1 | 100nF | C2 | C0805 | 100nF | CL21B104K CFNNNE | SAMSUNG( 三星) | C28233 | LCSC
3 | 1 | 4.7uF | C3 | C0805 | 4.7uF | CL21A475KA QNNNE | SAMSUNG( 三星) | C1779 | LCSC
4 | 2 | 1uF | C4,C6 | C0805 | 1uF | CL21B105KB FNNNE | SAMSUNG( 三星) | C28323 | LCSC
5 | 2 | 100uF | C5,C7 | C1206 | 100uF | CL31A107M QHNNNE | SAMSUNG( 三星) | C15008 | LCSC
6 | 9 | 10nF | C8,C9,C10,C11,C12,C13,C 14,C15,C16 | C0805 | 10nF | CL21B103KB ANNNC | SAMSUNG( 三星) | C1710 | LCSC
7 | 1 | PJ-603 | CN1 | AUDIO-TH_P J-603 | | PJ-603 | Legion(六钧) | C41409498 | LCSC
8 | 1 | HDR-F_2.54 _1x8P | H1 | HDR-TH_8P-P2.54-V-F-1
9 | 9 | PJ-612 | J1,J2,J3,J4,J5,J6,J8,J9,J10 | AUDIO-TH_P J-612 | | PJ-612 | HOOYA(皓宇 电子) | C309284 | LCSC
10 | 14 | 100k | R1,R2,R3,R4,R5,R7,R9,R1 2,R13,R17,R19,R23,R25,R 27 | R0805 | 100k | 0805W8F100 3T5E | UNI-ROYAL( 厚声) | C149504 | LCSC
11 | 10 | 1M | R6,R8,R10,R14,R15,R20,R 21,R24,R26,R28 | R0805 | 1M | 0805W8F100 4T5E | UNI-ROYAL( 厚声) | C17514 | LCSC
12 | 3 | 10k | R11,R22,R32 | R0805 | 10k | 0805W8F100 2T5E | UNI-ROYAL( 厚声) | C17414 | LCSC
13 | 2 | 4.7k | R16,R33 | R0805 | 4.7k | KTR10EZPF 4701 | ROHM(罗姆) | C2087066 | LCSC
14 | 1 | 10k | R30 | RES-ADJ-TH _RK09L1140 A65 | 10k | RK09L1140A 66 | ALPSALPIN E(阿尔卑斯阿 尔派) | C470447 | LCSC
15 | 3 | Key_SMD_6 x6x10.5 | SW1,SW2,SW3 | KEY-SMD_4 P-L6.0-W6.0-P3.90-LS9.0
16 | 1 | TDA1308T/N 1 | U1 | SOIC-8_L4.9 -W3.9-P1.27-LS6.0-BL | | TDA1308T/N 1 | NXP(恩智浦) | C29767341 | LCSC
17 | 1 | PCM5102 | U2 | PCM5102 | PCM5102
18 | 1 | ESP32-S3-N 16R8 | U4 | COMM-TH_E SP32-S3-DE VKITC-N16R 8 | | ESP32-S3-N 16R8 | | C990030979 2 | LCSC
19 | 1 | PJ-307 | U5 | AUDIO-TH_P J-307N5 | | PJ-307 | | C990001302 6 | LCSC
20 | 10 | BZT52C3V3 | ZD1,ZD2,ZD3,ZD4,ZD5,ZD 6,ZD7,ZD8,ZD9,ZD10 | SOD-123_L2 .8-W1.8-LS3. 7-RD | | BZT52C3V3 | CJ(江苏长电/ 长晶) | C2112 | LCSC

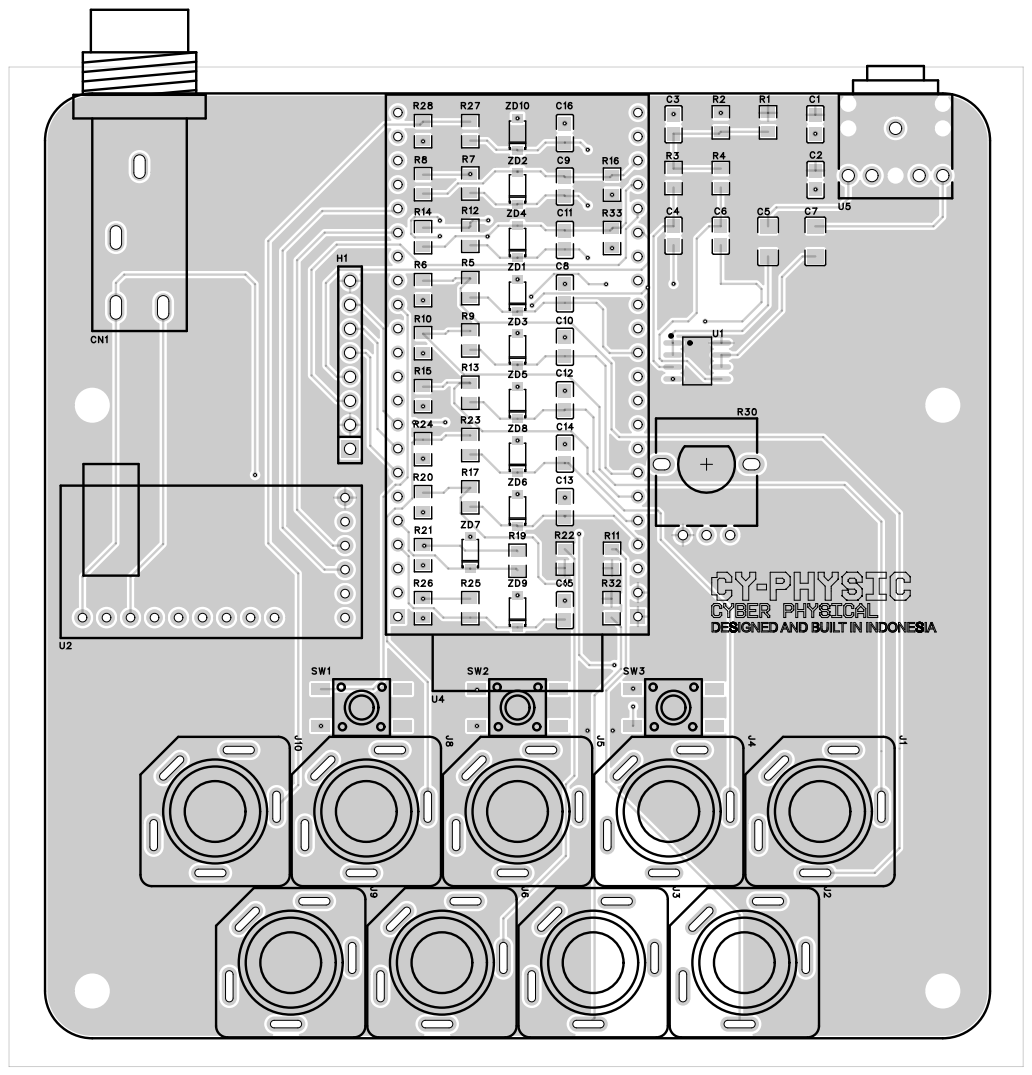
[picture p44: page 4]

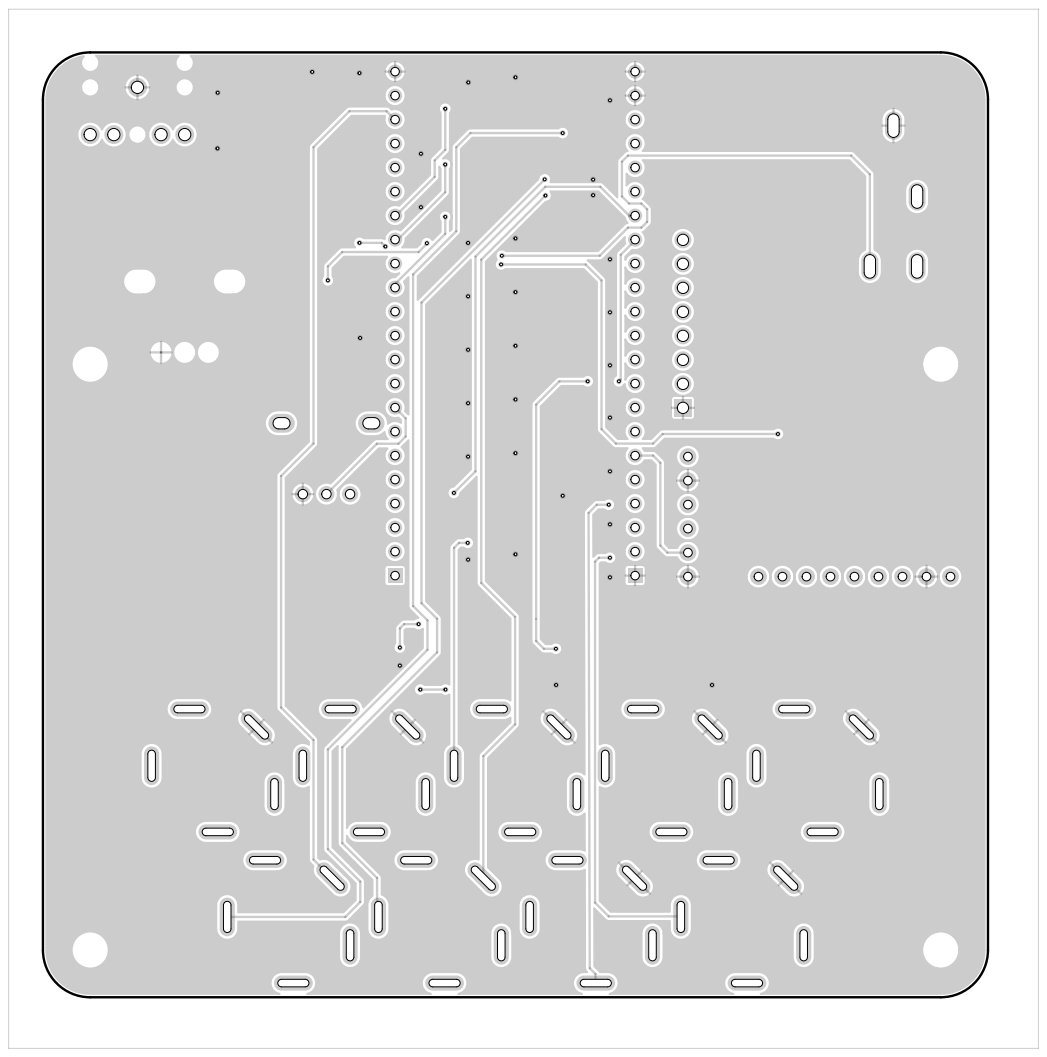
[picture p45: page 5]

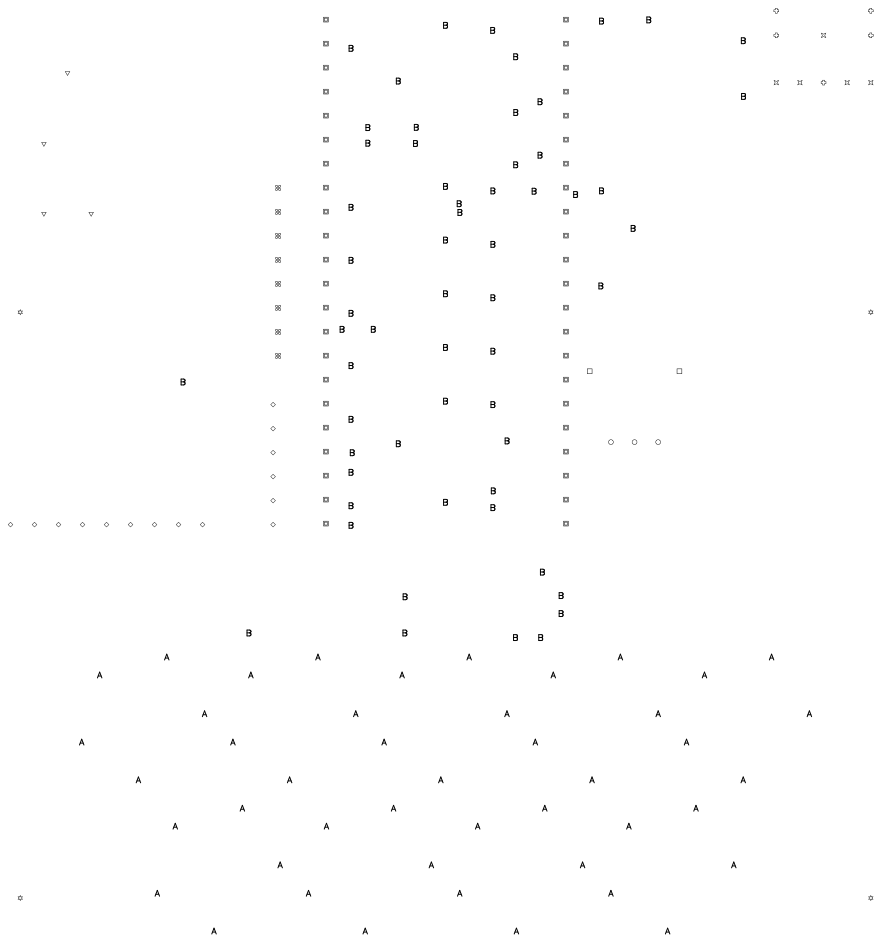
[picture p46: page 6]
