AlvinStf/electronic-drum-kit/PCB/sensors/PCB_sensors.pdf

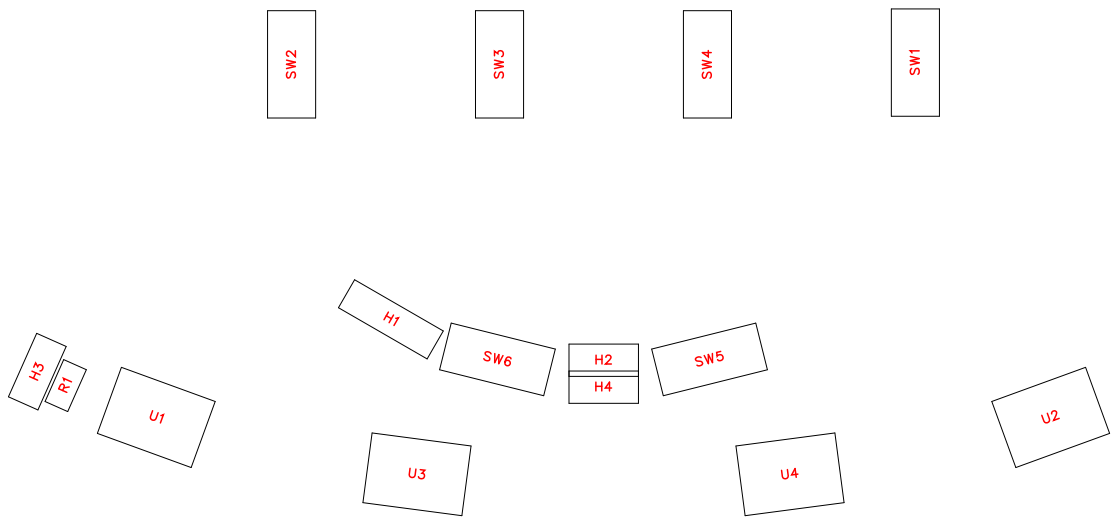
[picture p47: page 1]

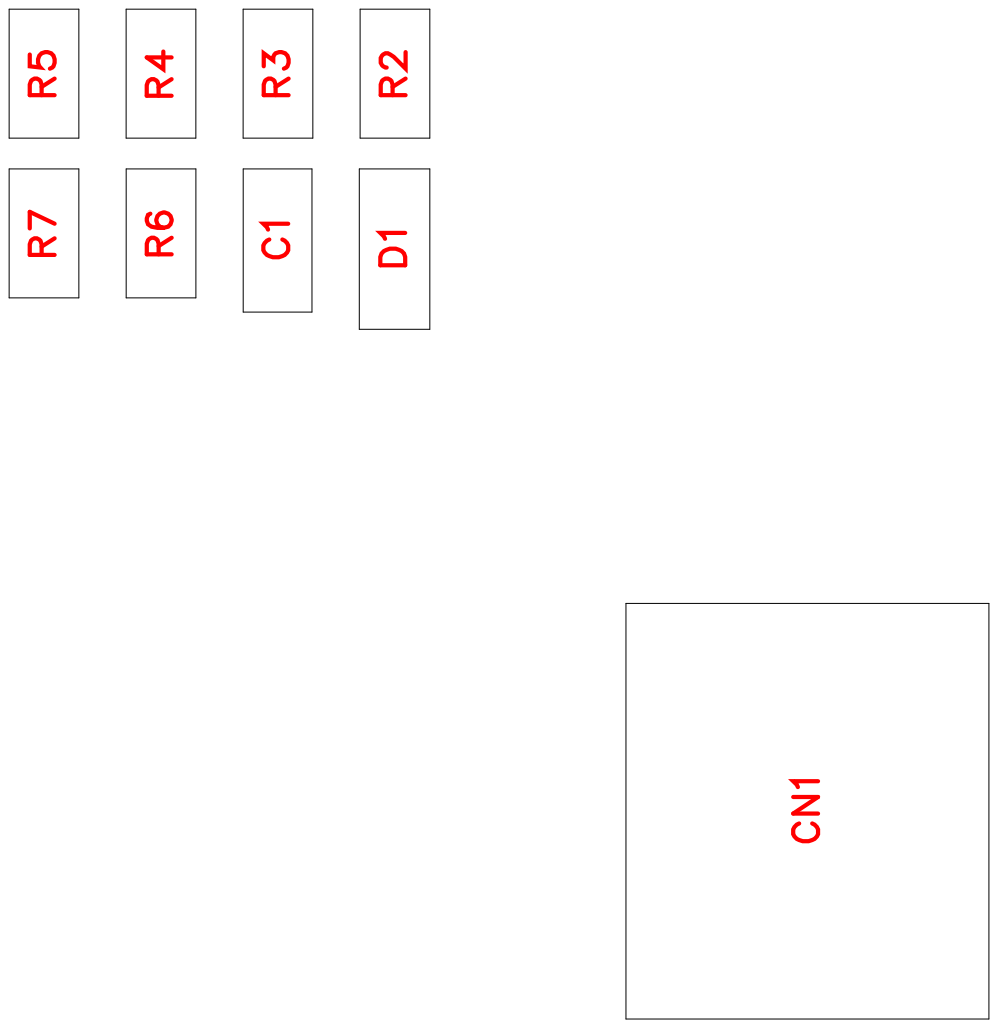
[picture p48: page 2]

No. | Quantity | Comment | Designator | Footprint | Value | Manufacturer Part | Manufacturer | Supplier Part | Supplier
1 | 1 | 100pF | C1 | C0805 | 100pF | CL21C101JB ANNNC | SAMSUNG( 三星) | C1790 | LCSC
2 | 1 | S3B-XH-A(L F)(SN) | CN1 | CONN-TH_S 3B-XH-A-LF-SN | | S3B-XH-A(L F)(SN) | JST | C157928 | LCSC
3 | 1 | 1N4148W | D1 | SOD-123F_L 2.7-W1.6-LS 3.8-RD | | 1N4148W | ST(先科) | C81598 | LCSC
4 | 1 | HDR-F_2.54 _1x3P | H1 | HDR-TH_3P-P2.54-V-F
5 | 3 | 2.54-1*2P母 | H2,H3,H4 | HDR-TH_2P-P2.54-V-F | | 2.54-1*2P母 | BOOMELE( 博穆精密) | C49661 | LCSC
6 | 2 | 10k | R1,R7 | R0805 | 10k | 0805W8F100 2T5E | UNI-ROYAL( 厚声) | C17414 | LCSC
7 | 2 | 150k | R2,R5 | R0805 | 150k | 0805W8F150 3T5E | UNI-ROYAL( 厚声) | C17470 | LCSC
8 | 1 | 220 | R3 | R0805 | 220 | 0805W8F220 0T5E | UNI-ROYAL( 厚声) | C17557 | LCSC
9 | 1 | 1k | R4 | R0805 | 1k | 0805W8F100 1T5E | UNI-ROYAL( 厚声) | C17513 | LCSC
10 | 1 | 47k | R6 | R0805 | 47k | 0805W8F470 2T5E | UNI-ROYAL( 厚声) | C17713 | LCSC
11 | 6 | TS-1101-C-W | SW1,SW2,SW3,SW4,SW5, SW6 | SW-SMD_L6 .0-W3.3-LS8. 0_TS-1101-C -W | | TS-1101-C-W | XKB Connect ion(中国星坤) | C318938 | LCSC
12 | 4 | TS5208A 160gf 025 | U1,U2,U3,U4 | KEY-SMD_4 P-L4.8-W4.8-P3.70-LS6.4-TL | | TS5208A 160gf 025 | SHOU HAN(首韩) | C5363479 | LCSC

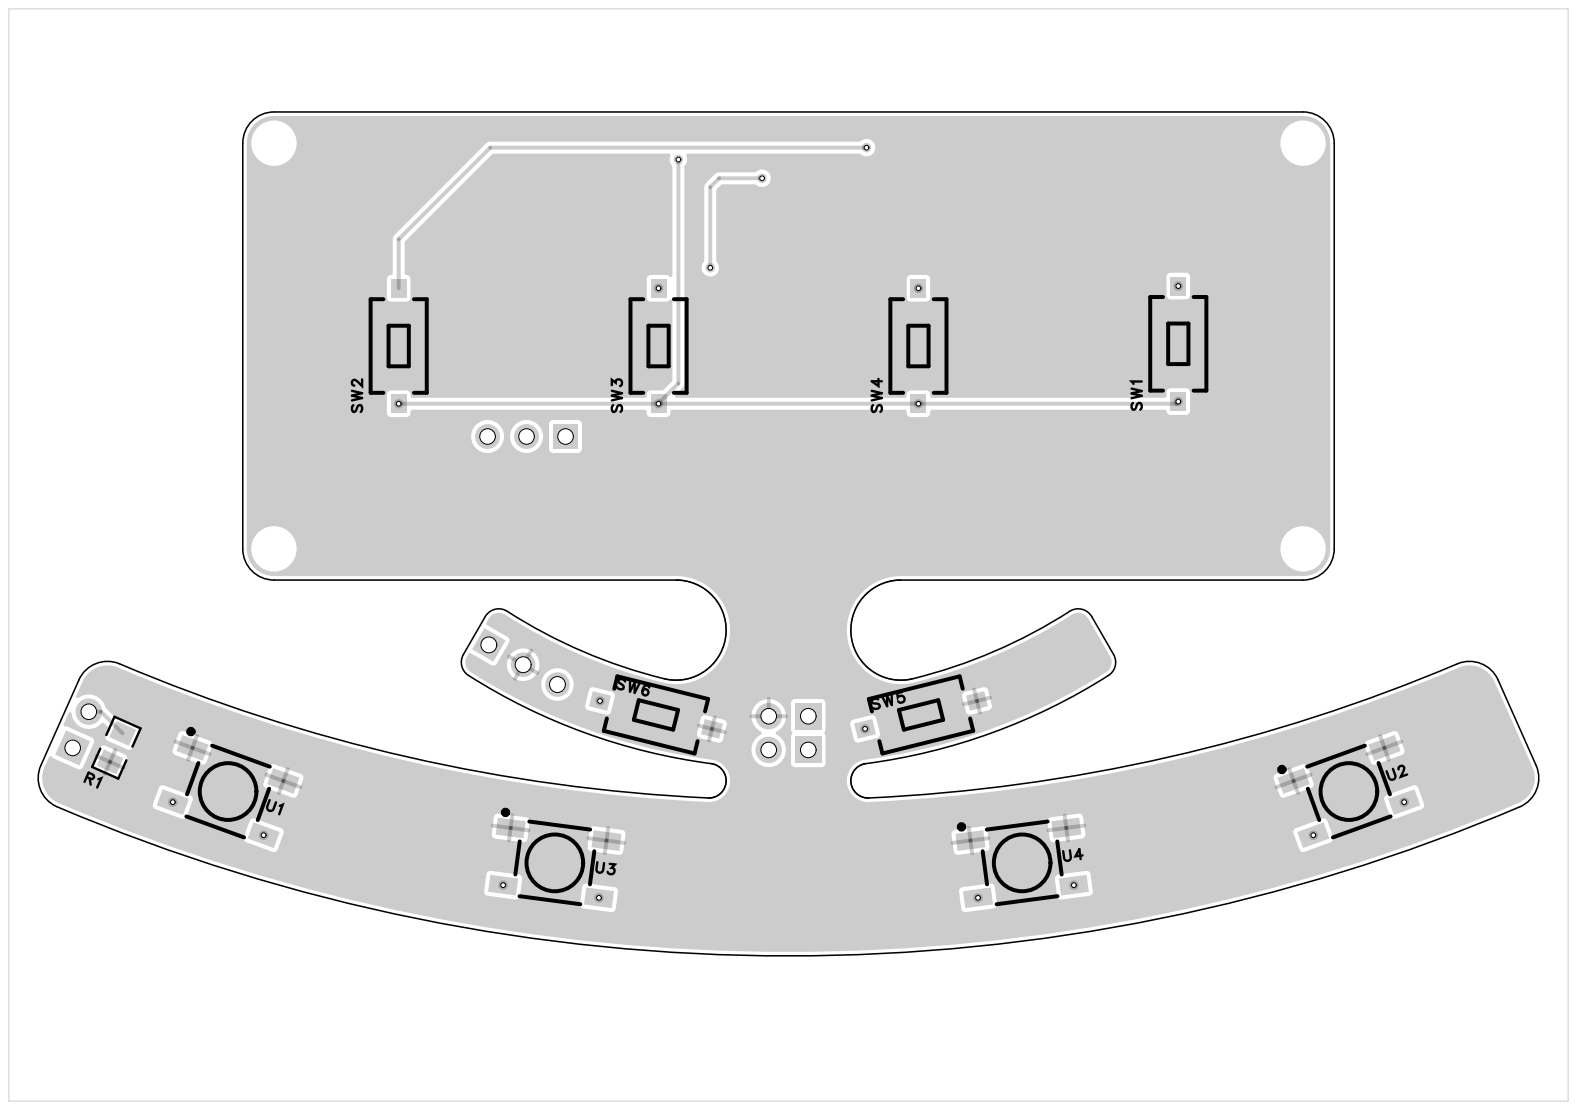
[picture p49: page 4]

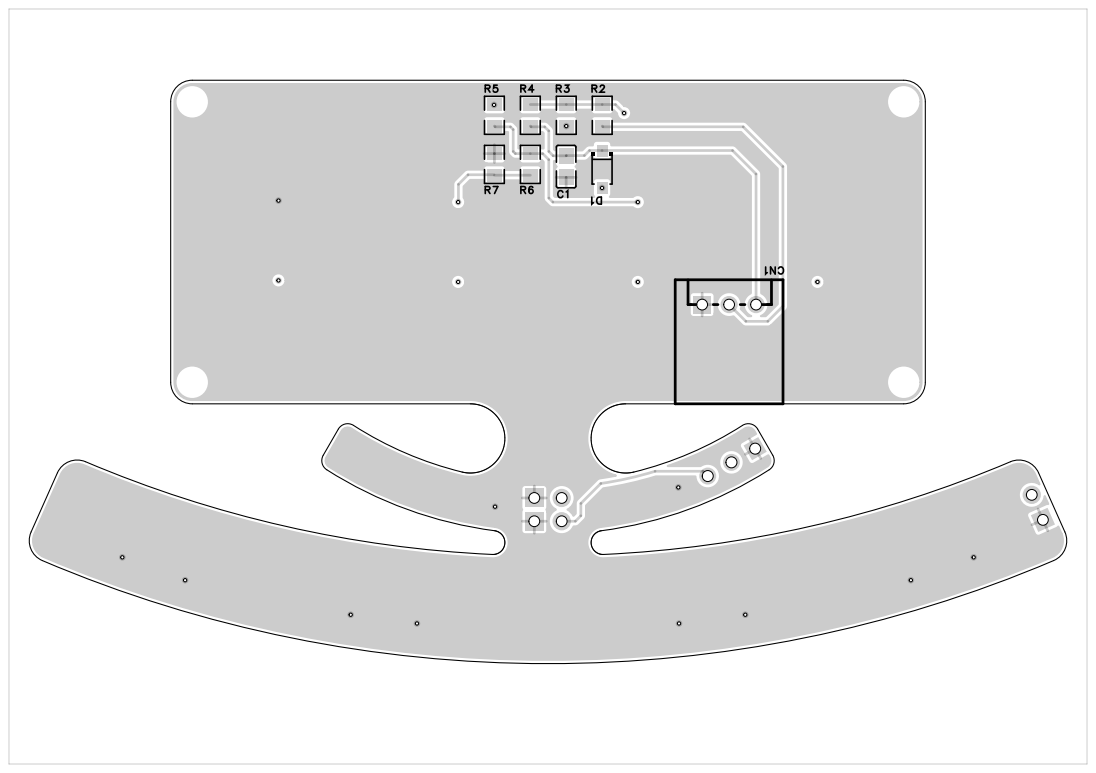
[picture p50: page 5]

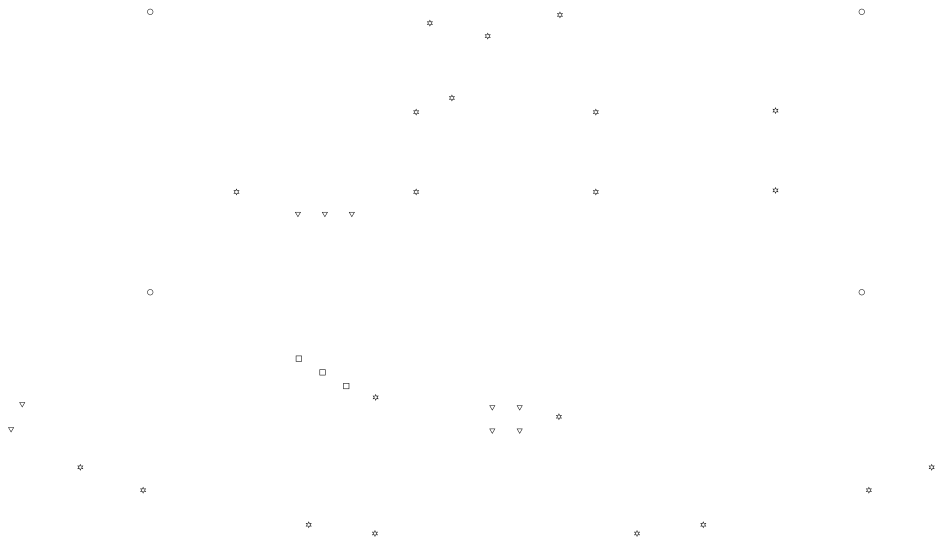
[picture p51: page 6]
