AlvinStf/electronic-drum-kit/firmware/src/SnareRim.h

#pragma once

#include <Arduino.h>

const uint8_t SnareRim[] PROGMEM  = {
  0x52, 0x49, 0x46, 0x46, 0xc2, 0x94, 0x00, 0x00, 0x57, 0x41, 0x56, 0x45, 0x66, 0x6d, 0x74, 0x20, 
  0x10, 0x00, 0x00, 0x00, 0x01, 0x00, 0x01, 0x00, 0x44, 0xac, 0x00, 0x00, 0x88, 0x58, 0x01, 0x00, 
  0x02, 0x00, 0x10, 0x00, 0x64, 0x61, 0x74, 0x61, 0x9e, 0x94, 0x00, 0x00, 0xfa, 0xff, 0xf8, 0xff, 
  0xfa, 0xff, 0xf9, 0xff, 0xfa, 0xff, 0xf6, 0xff, 0xfc, 0xff, 0xf6, 0xff, 0xfb, 0xff, 0xf9, 0xff, 
  0xf8, 0xff, 0xf9, 0xff, 0xf9, 0xff, 0xf9, 0xff, 0xf8, 0xff, 0xfb, 0xff, 0xf6, 0xff, 0xfc, 0xff, 
  0xf8, 0xff, 0xf8, 0xff, 0xfa, 0xff, 0xf9, 0xff, 0xf7, 0xff, 0xfd, 0xff, 0xf5, 0xff, 0xfc, 0xff, 
  0xf7, 0xff, 0xfa, 0xff, 0xf7, 0xff, 0xfc, 0xff, 0xf6, 0xff, 0xfb, 0xff, 0xf9, 0xff, 0xf5, 0xff, 
  0x00, 0x00, 0xf2, 0xff, 0xfe, 0xff, 0xf7, 0xff, 0xf8, 0xff, 0xfa, 0xff, 0xfa, 0xff, 0xf6, 0xff, 
  0xfd, 0xff, 0xf4, 0xff, 0xfc, 0xff, 0xf9, 0xff, 0xf7, 0xff, 0xfb, 0xff, 0xf6, 0xff, 0xfc, 0xff, 
  0xf7, 0xff, 0xfa, 0xff, 0xf8, 0xff, 0xf9, 0xff, 0xfb, 0xff, 0xf6, 0xff, 0xfc, 0xff, 0xf5, 0xff, 
  0xfe, 0xff, 0xf3, 0xff, 0xff, 0xff, 0xf3, 0xff, 0xff, 0xff, 0xf4, 0xff, 0xfc, 0xff, 0xf7, 0xff, 
  0xfa, 0xff, 0xf8, 0xff, 0xfb, 0xff, 0xf6, 0xff, 0xfb, 0xff, 0xf9, 0xff, 0xf6, 0xff, 0xfe, 0xff, 
  0xf3, 0xff, 0xfd, 0xff, 0xf7, 0xff, 0xfb, 0xff, 0xf6, 0xff, 0xfb, 0xff, 0xf8, 0xff, 0xfa, 0xff, 
  0xf8, 0xff, 0xfa, 0xff, 0xf7, 0xff, 0xfb, 0xff, 0xf8, 0xff, 0xf9, 0xff, 0xf9, 0xff, 0xfa, 0xff, 
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
  0xfa, 0xff, 0xf7, 0xff, 0xfc, 0xff, 0xf6, 0xff, 0xfb, 0xff, 0xf6, 0xff, 0xfb, 0xff, 0xfa, 0xff, 
  0xf8, 0xff, 0xfb, 0xff, 0xf6, 0xff, 0xfc, 0xff, 0xf6, 0xff, 0xfa, 0xff, 0xf8, 0xff, 0xf7, 0xff, 
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
};
