AlvinStf/electronic-drum-kit/(commit log)

2026-10-11 Initial import: ESP32-S3 drum with MIDI, PCM5102, and ST7789
2026-10-14 Add new files
    Add hardware and PCB design files.
    [BOM.xlsx, Bottom Pad.STL, Clasp.STL, Cymbal Bell.STL, Cymbal Edge.STL, Cymbal Main Body.STL, Cymbal Mount.STL, Cymbal Sleeve.STL]
